panatmospheric-voyage/filament-winder/Electronics/Power Budget.xlsx

Power Rail | FPGA draw | Stepper draw | DAC draw | Heating element draw | Fan draw | DC motor draw | Accelerometer draw | Potentiometer draw | Raspberry Pi draw | Ethernet draw | Power draw | Total draw
1V2 | 0.05 |  |  |  |  |  |  |  |  |  |  | 0.05
1V65 |  |  |  |  |  |  |  |  |  | 0.006 |  | 0.006
3V3 | 0.13 |  | 0.004 |  |  |  | 0.001 | 0.2 |  |  | 0.056 | 0.391
5V |  |  |  |  |  |  |  |  | 2 |  | 0.25806 | 2.25806
12V |  |  |  |  | 0.14 |  |  |  |  |  | 9 | 9.14
STEPPER |  | 3 |  |  |  |  |  |  |  |  |  | 3
HEATER |  |  |  | 6 |  |  |  |  |  |  |  | 6
MOTOR |  |  |  |  |  | 50 |  |  |  |  |  | 50
