panatmospheric-voyage/filament-winder/Laser-Cutting.xlsx

Part | Configuration | Count | Thickness | Fit Against
Axle Support | Default | 2 | 0.5 | Bearing
Basin Plate | Default | 1 | 0.5 | Epoxy Plate
Carver Centering Ring | Forward | 1 | 0.5 | Clamp
Carver Centering Ring | Rear | 1 | 0.5 | Clamp
Centering Ring | 3-8in - 0.5in schedule 40 | 2 | 0.5 | 0.5" PVC
Centering Ring | 5mm - 1in schedule 40 | 4 | 0.5 | 1" PVC
Centering Ring | Inside Spool | 2 | 0.5 | Spool
Centering Ring | Outside Spool | 2 | 0.25 | Spool
Chord Ring | Horizontal | 4 | 0.5 | Chord Ring, Pulley Plate
Chord Ring | Vertical | 2 | 0.5 | Chord Ring, Pulley Plate
Clamp | Default | 4 | 0.5 | Carver Centering Ring
Clamp Plate | Thick | 1 | 0.5
Clamp Plate | Thin | 1 | 0.25
Epoxy Plate | Default | 2 | 0.5 | Basin Plate
Fan Plate | Inside | 1 | 0.5 | Fan
Fan Plate | Outside | 1 | 0.25 | Fan
Filament Guide | Default | 1 | 0.25
Filament Plate | Default | 2 | 0.5 | Bearing
Idler Plate | Inner | 3 | 0.25
Idler Plate | Outer | 1 | 0.5
Pipe Plate | Bottom Mount | 1 | 0.5
Pipe Plate | Side Mount | 1 | 0.5
Pulley Plate | Default | 2 | 0.5 | Chord Ring
Resistance Strip Mold - End Cap | Default | 4 | 0.25 | 2020, Resistance Strip Mold - Side Strip
Resistance Strip Mold - Side Strip | Default | 10 | 0.25 | 2020, Resistance Strip Mold - End Cap
Stepper Plate | Narrow | 3 | 0.25 | Stepper
Stepper Plate | Wide | 2 | 0.25 | Stepper
Wheel Bracket | Default | 4 | 0.5
Wheel Bracket | Potentiometer | 1 | 0.5
Z Pulley | Theta Axis | 1 | 0.5 | Belt
Z Pulley | Z Axis | 1 | 0.5 | Belt
