panatmospheric-voyage/filament-winder/Resistance Strip Mold.SLDASM

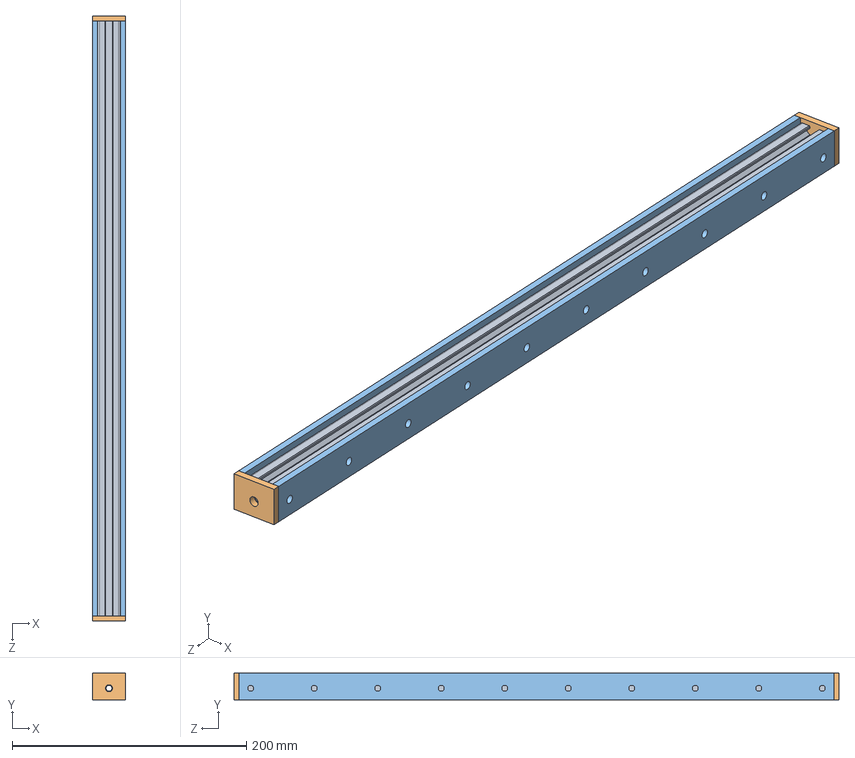
[picture p1: CAD file, 2019-07-26]
Resistance Strip Mold.SLDASM
28.6 x 23.0 x 516.6 mm
Aluminum Extrusion
Resistance Strip Mold - End Cap x 2
Resistance Strip Mold - Side Strip x 2
