panatmospheric-voyage/filament-winder/Gantry Z.SLDASM

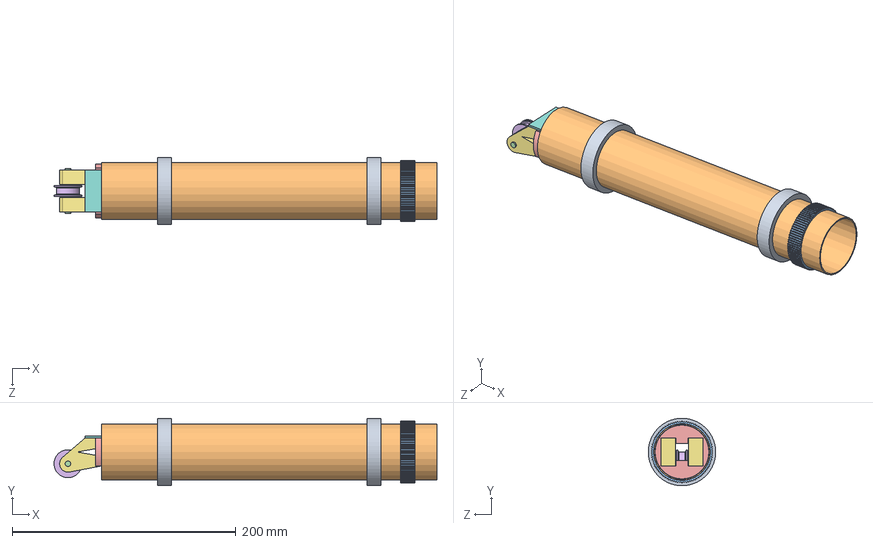
[picture p2: CAD file, 2019-07-26]
Gantry Z.SLDASM
342.5 x 60.3 x 60.3 mm
Bearing x 3
Pipe
Z Pulley
Axle
Chord Ring x 6
Filament Pulley
Pulley Plate x 2
Accelerometer PCB
