panatmospheric-voyage/filament-winder/Roller.SLDASM

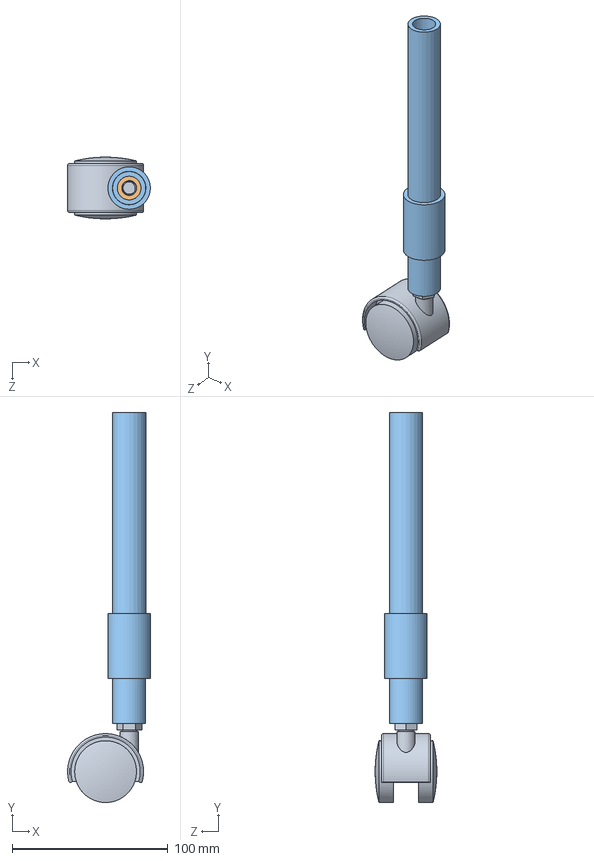
[picture p3: CAD file, 2019-07-26]
Roller.SLDASM
53.2 x 250.6 x 39.7 mm
24215T350_LIGHT DUTY CASTER WITH HOOD
Centering Ring
Pipe x 3
