panatmospheric-voyage/filament-winder/Filament Tool.SLDASM

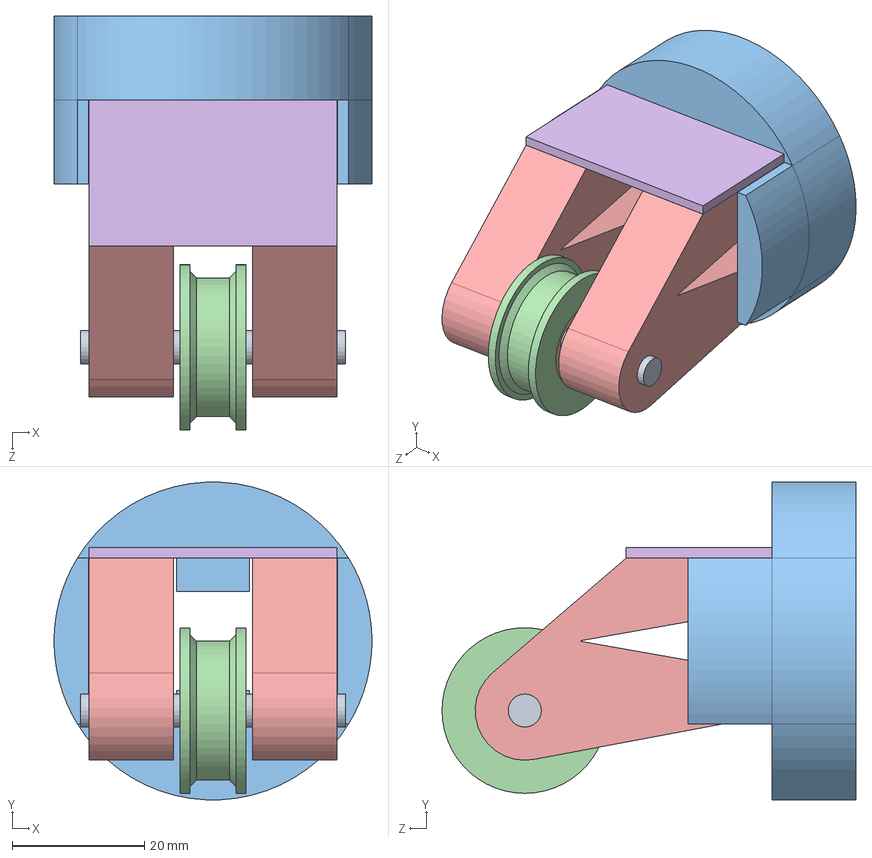
[picture p4: CAD file, 2019-07-26]
Filament Tool.SLDASM
48.0 x 47.9 x 62.5 mm
Axle
Bearing
Chord Ring x 6
Filament Pulley
Pulley Plate x 2
Accelerometer PCB
