panatmospheric-voyage/filament-winder/Rotating Assembly.SLDASM

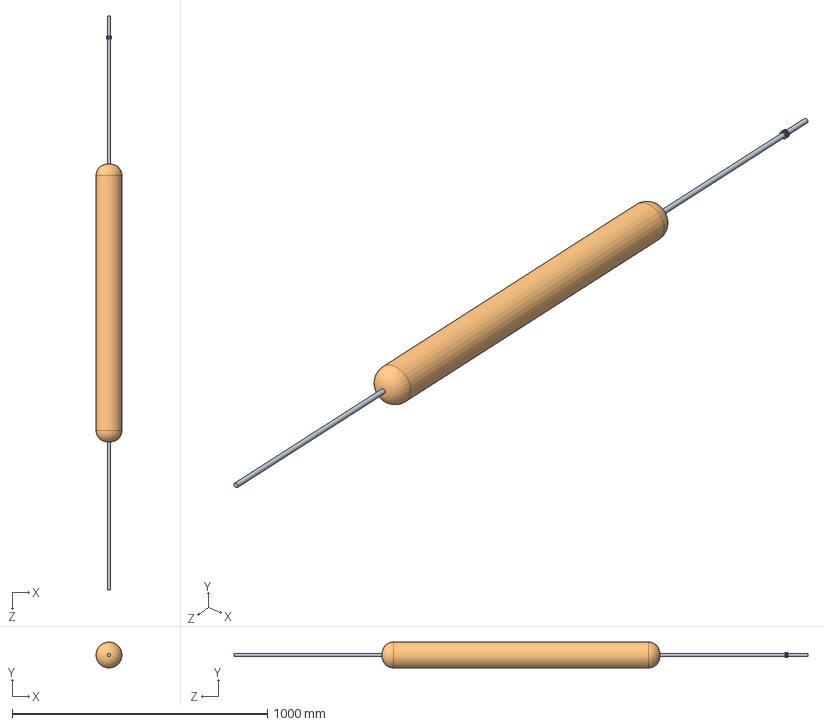
[picture p5: CAD file, 2019-07-26]
Rotating Assembly.SLDASM
101.6 x 101.6 x 2250.0 mm
Axle
Example Mandrel
Z Pulley
