panatmospheric-voyage/filament-winder/MDF 0.5in - Filament Winder.SLDASM

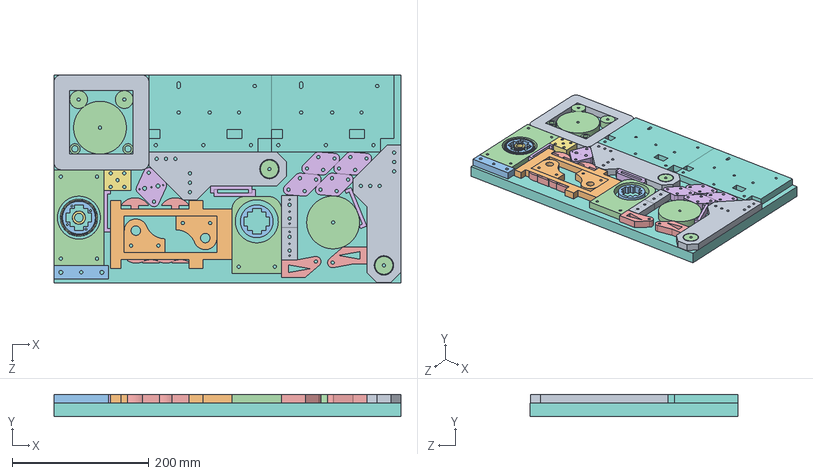
[picture p6: CAD file, 2019-07-26]
MDF 0.5in - Filament Winder.SLDASM
508.0 x 32.7 x 304.8 mm
Axle Support x 2
Basin Plate
Carver Centering Ring x 2
Centering Ring x 8
Chord Ring x 6
Clamp x 4
Clamp Plate
Epoxy Plate x 2
Fan Plate
Filament Plate x 2
Idler Plate
Pipe Plate x 2
Pulley Plate x 2
Wheel Bracket x 5
Z Pulley x 2
Laser Sheet
Potentiometer Plate x 2
