panatmospheric-voyage/filament-winder/MDF 0.25in - Filament Winder.SLDASM

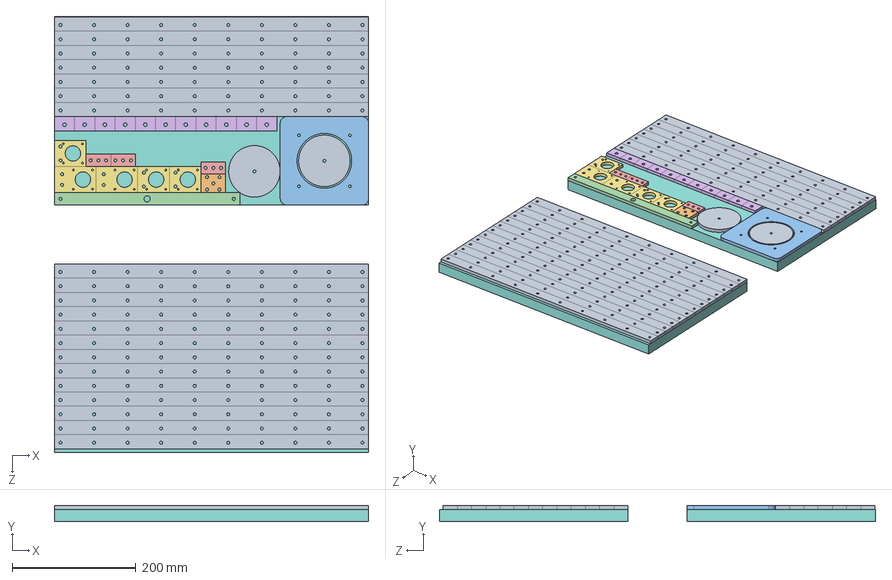
[picture p7: CAD file, 2019-07-26]
MDF 0.25in - Filament Winder.SLDASM
508.0 x 26.4 x 704.8 mm
Centering Ring x 2
Clamp Plate
Fan Plate
Filament Guide
Idler Plate x 3
Resistance Strip Mold - End Cap x 11
Stepper Plate x 5
Laser Sheet x 2
Resistance Strip Mold - Side Strip x 20
