panatmospheric-voyage/filament-winder/Gantry X.SLDASM

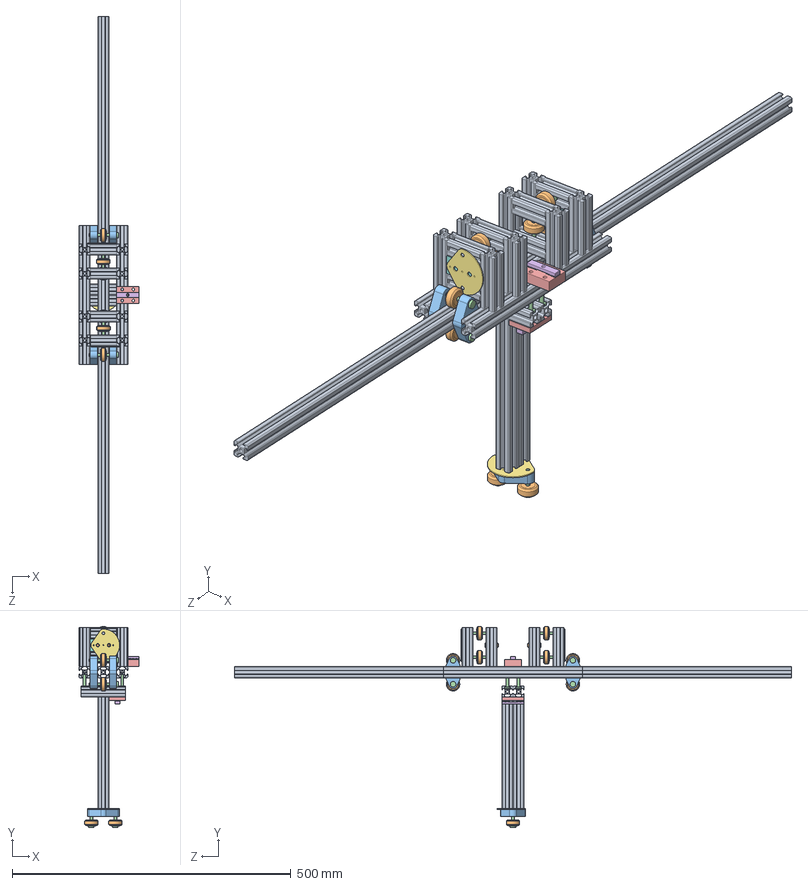
[picture p8: CAD file, 2019-07-26]
Gantry X.SLDASM
107.4 x 360.5 x 1000.0 mm
Wheel x 12
Wheel Bracket x 5
Aluminum Extrusion x 22
Bolt x 16
Clamp Plate x 2
Gear Clamp x 2
Potentiometer PCB x 3
Potentiometer Plate x 2
