panatmospheric-voyage/filament-winder/Base.SLDASM

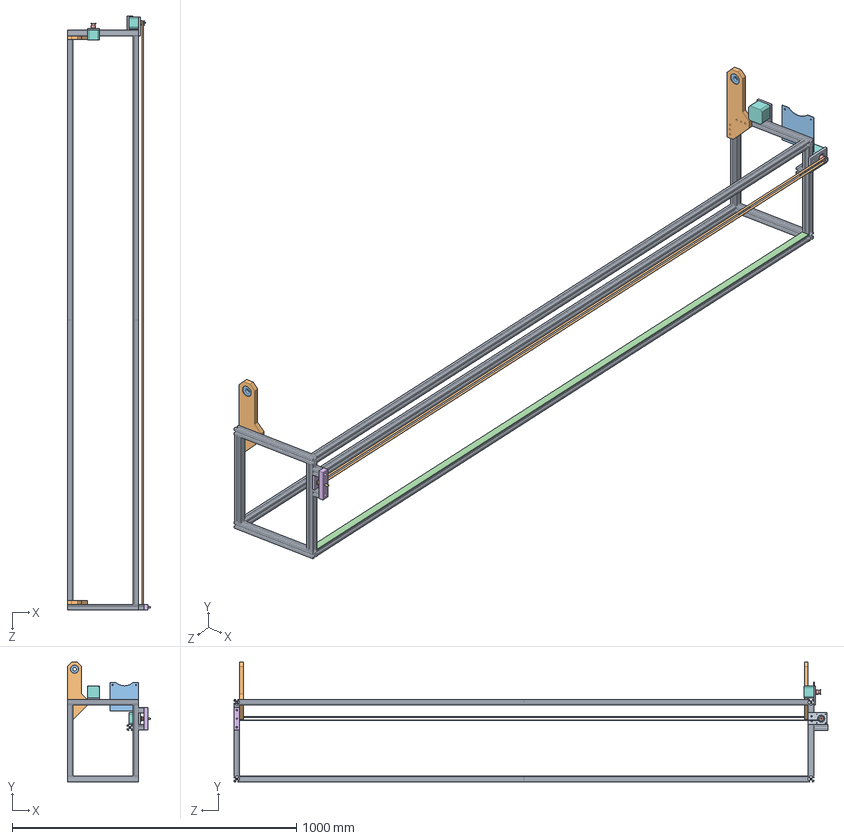
[picture p9: CAD file, 2019-07-26]
Base.SLDASM
292.0 x 421.4 x 2090.0 mm
Aluminum Extrusion x 17
Axle Support x 2
Bearing x 2
Resistance Strip
Pulley x 3
Idler Plate x 2
Axle
Stepper Motor x 2
Stepper Plate x 2
Belt
Control PCB
