panatmospheric-voyage/filament-winder/Carving Tool.SLDASM

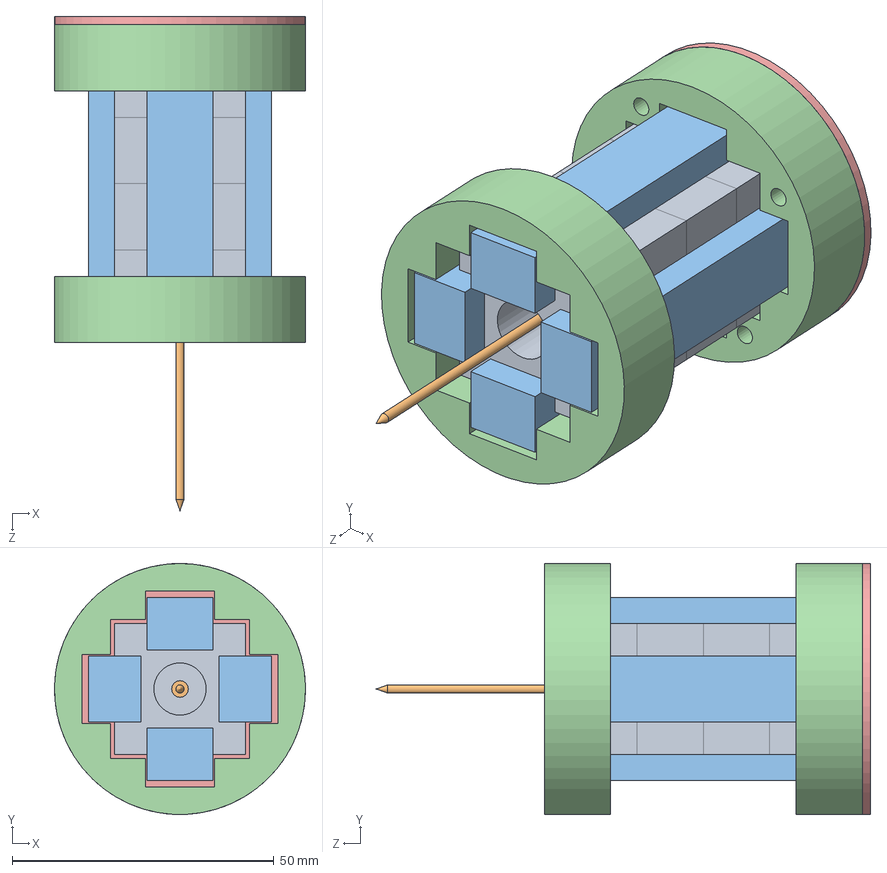
[picture p10: CAD file, 2019-07-26]
Carving Tool.SLDASM
48.0 x 48.0 x 94.5 mm
Insulation Square x 4
Nail
Clamp x 4
Carver Centering Ring x 2
Carver PCB
