panatmospheric-voyage/filament-winder/MDF 0.5in - Filament Winder - 2.SLDASM

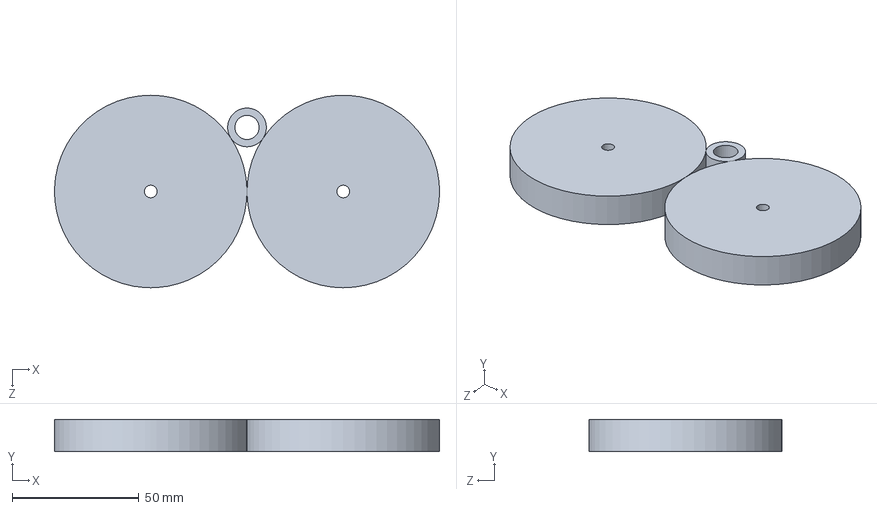
[picture p11: CAD file, 2019-07-26]
MDF 0.5in - Filament Winder - 2.SLDASM
152.0 x 12.7 x 76.0 mm
Centering Ring x 3
