panatmospheric-voyage/filament-winder/Gantry Y.SLDASM

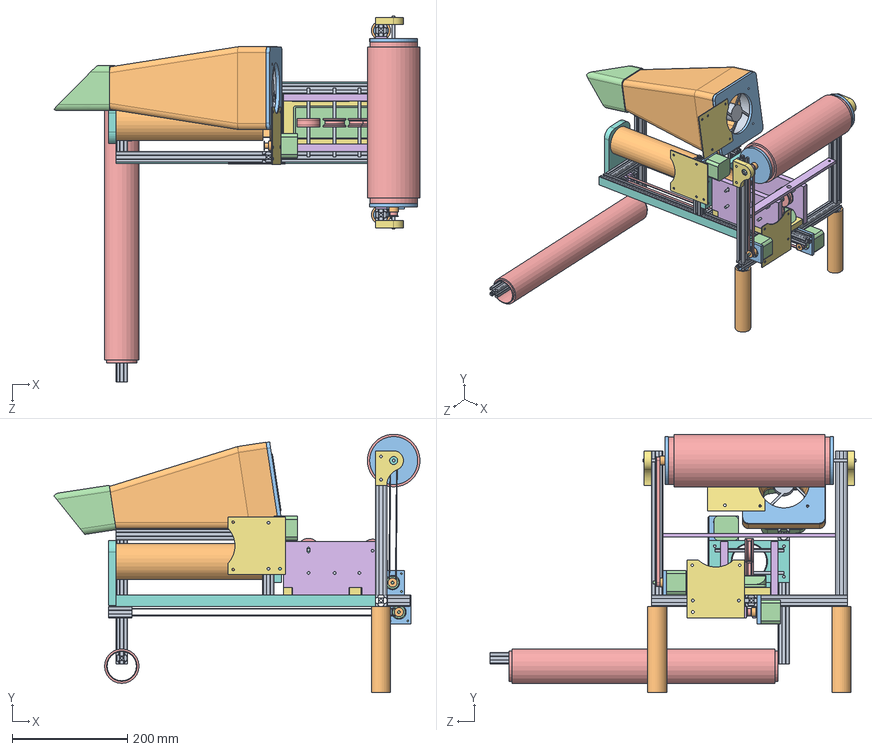
[picture p12: CAD file, 2019-07-26]
Gantry Y.SLDASM
635.4 x 448.5 x 635.0 mm
Aluminum Extrusion x 16
Pipe x 3
Centering Ring x 8
Basin
Filament Spool x 2
Filament Guide
Filament Plate x 2
Bearing x 7
Axle x 6
Pulley x 5
Stepper Plate x 3
Stepper Motor x 3
Filament Pulley x 5
Epoxy Plate x 2
Basin Plate
Pipe Plate x 2
Fan
Heating Chamber
Fan Plate x 2
Heat Attachment
Belt x 2
Idler Plate x 2
Control PCB x 3
Resistance Strip x 2
