panatmospheric-voyage/filament-winder/Filament Winder.SLDASM

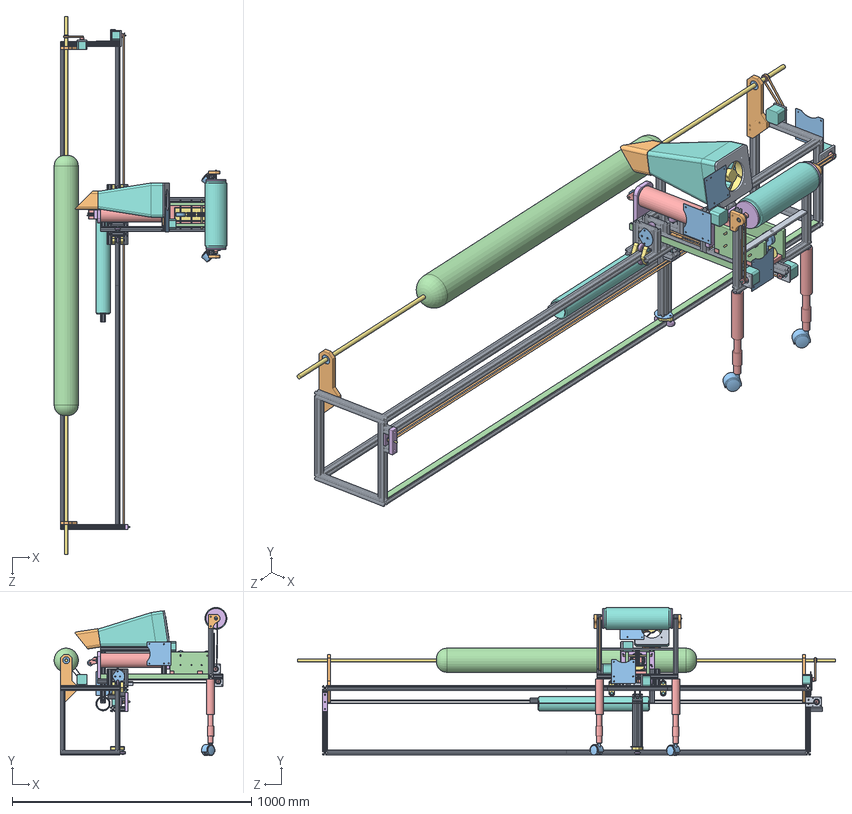
[picture p13: CAD file, 2019-07-26]
Filament Winder.SLDASM
722.4 x 619.1 x 2250.0 mm
Aluminum Extrusion x 55
Axle Support x 2
Bearing x 12
Resistance Strip x 3
Pulley x 8
Idler Plate x 4
Axle x 9
Stepper Motor x 5
Stepper Plate x 5
Belt x 5
Control PCB x 4
Example Mandrel
Z Pulley x 2
Wheel x 12
Wheel Bracket x 5
Bolt x 16
Clamp Plate x 2
Gear Clamp x 2
Potentiometer PCB x 3
Potentiometer Plate x 2
Pipe x 10
Centering Ring x 10
Basin
Filament Spool x 2
Filament Guide
Filament Plate x 2
Filament Pulley x 6
Epoxy Plate x 2
Basin Plate
Pipe Plate x 2
Fan
Heating Chamber
Fan Plate x 2
Heat Attachment
24215T350_LIGHT DUTY CASTER WITH HOOD x 2
Chord Ring x 6
Pulley Plate x 2
Accelerometer PCB
