panatmospheric-voyage/filament-winder/Filament Pulley.SLDPRT

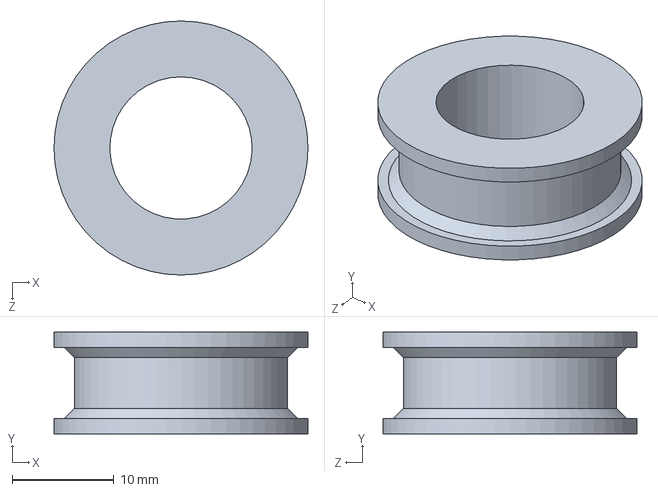
[picture p14: CAD file, 2020-02-10]
Filament Pulley.SLDPRT
25.0 x 10.0 x 25.0 mm
