panatmospheric-voyage/filament-winder/Filament Pulley Injection Mold.SLDPRT

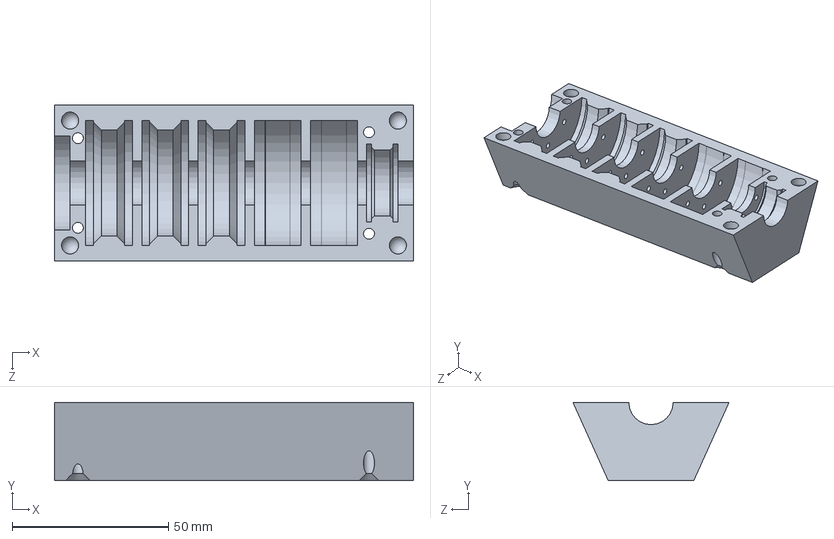
[picture p15: CAD file, 2020-02-10]
Filament Pulley Injection Mold.SLDPRT
115.0 x 25.0 x 50.0 mm
