panatmospheric-voyage/filament-winder/Pulley Plate.SLDPRT

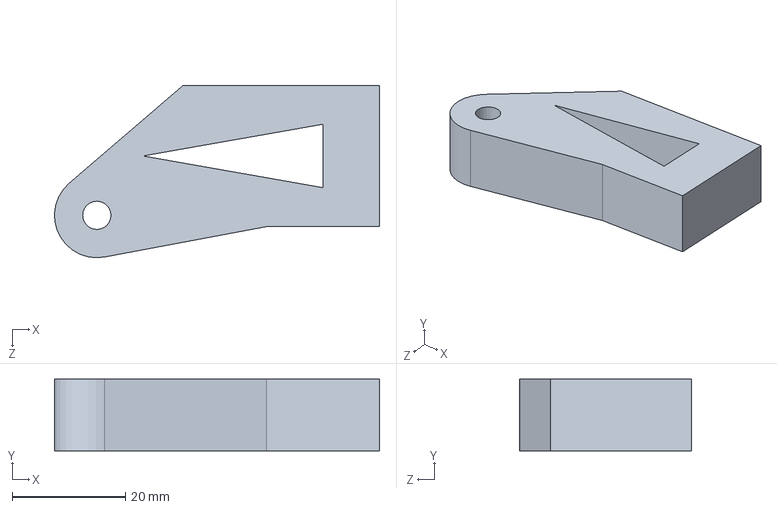
[picture p16: CAD file, 2019-07-26]
Pulley Plate.SLDPRT
57.5 x 12.7 x 30.5 mm
