panatmospheric-voyage/filament-winder/Resistance Strip Mold - Side Strip.SLDPRT

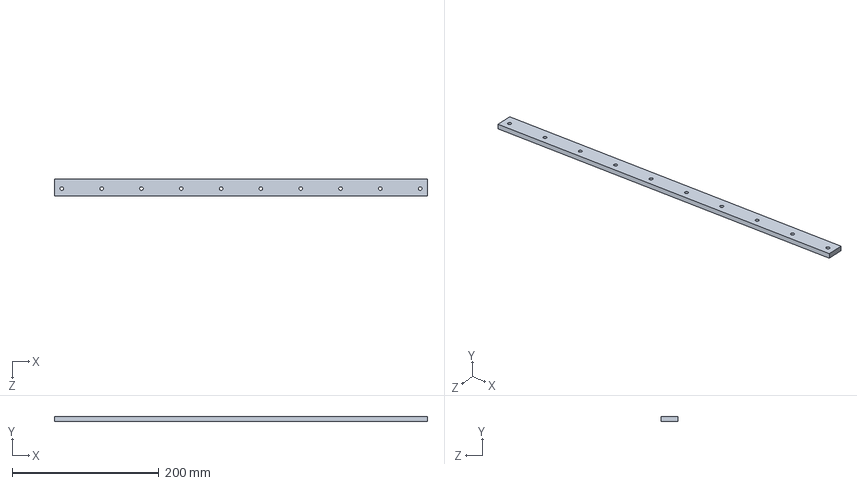
[picture p17: CAD file, 2019-07-26]
Resistance Strip Mold - Side Strip.SLDPRT
508.0 x 6.35 x 23.0 mm
