panatmospheric-voyage/filament-winder/Pulley.SLDPRT

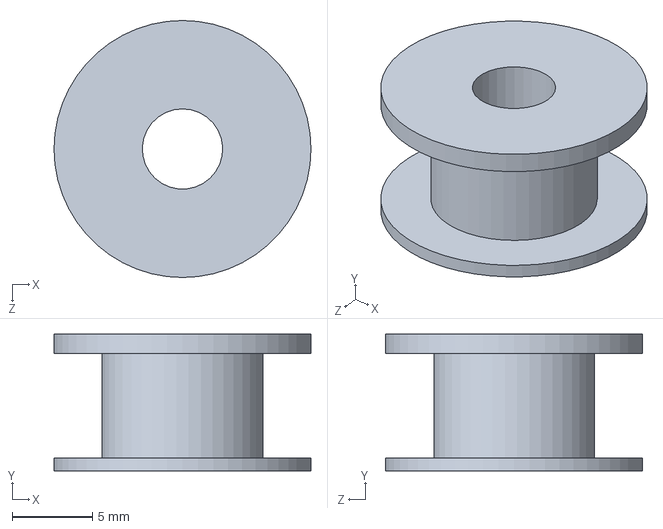
[picture p18: CAD file, 2019-07-26]
Pulley.SLDPRT
16.0 x 8.50 x 16.0 mm
