panatmospheric-voyage/filament-winder/Control PCB.SLDPRT

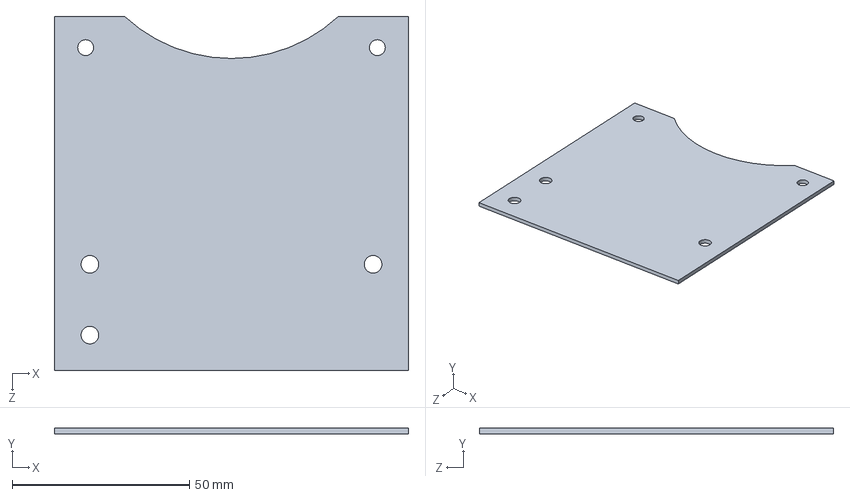
[picture p19: CAD file, 2019-07-26]
Control PCB.SLDPRT
100.0 x 1.60 x 100.0 mm
