panatmospheric-voyage/filament-winder/Bearing.SLDPRT

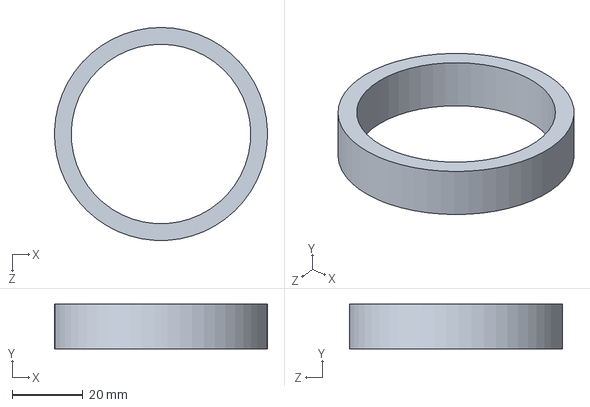
[picture p20: CAD file, 2019-07-26]
Bearing.SLDPRT
60.3 x 12.7 x 60.3 mm
