panatmospheric-voyage/filament-winder/Basin Plate.SLDPRT

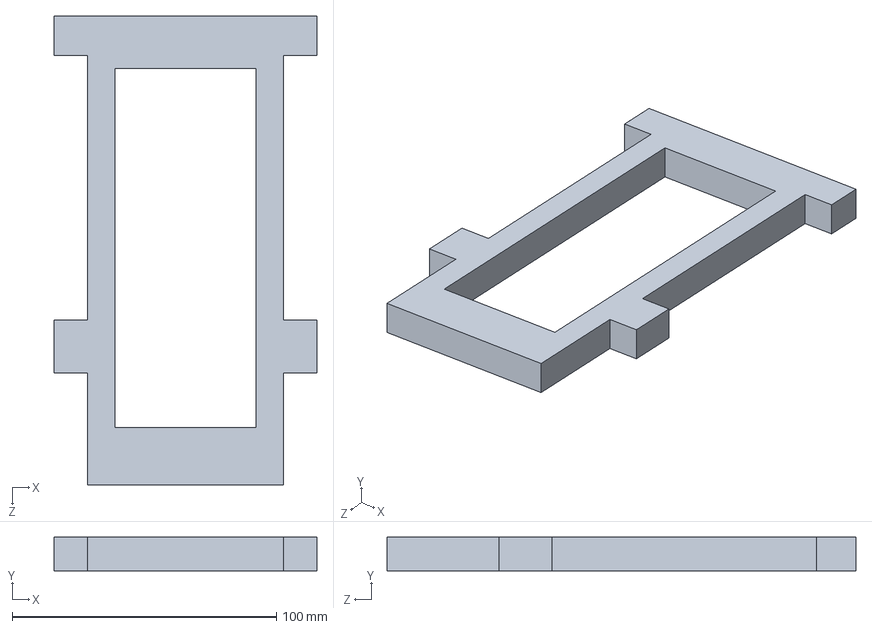
[picture p21: CAD file, 2019-07-26]
Basin Plate.SLDPRT
99.4 x 12.7 x 177.4 mm
