panatmospheric-voyage/filament-winder/Aluminum Extrusion.SLDPRT

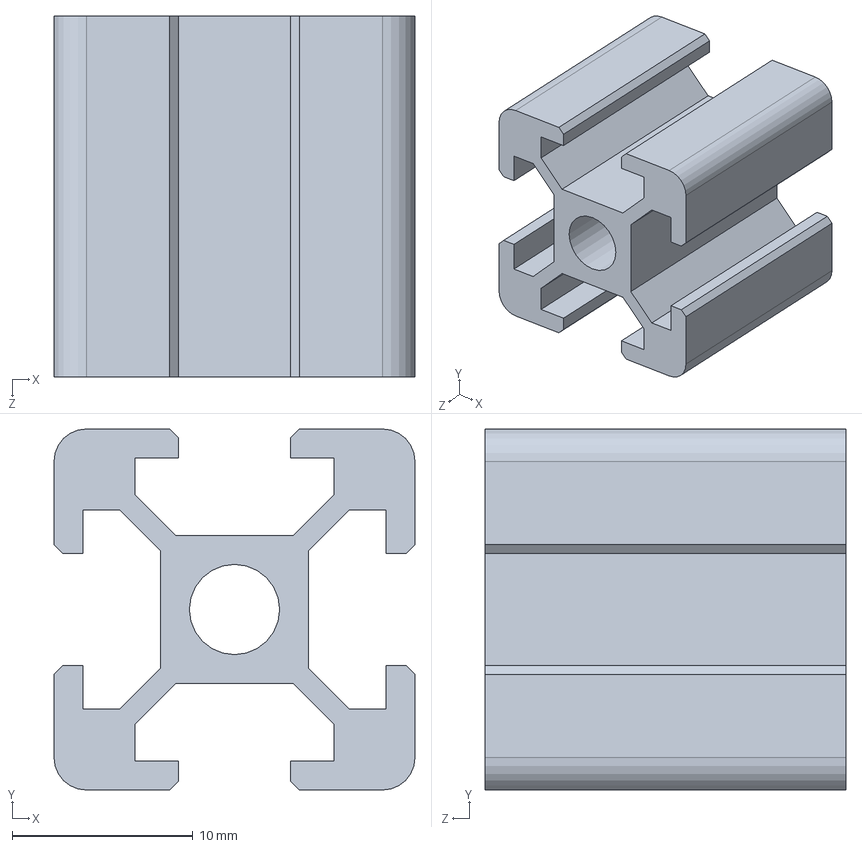
[picture p22: CAD file, 2019-07-26]
Aluminum Extrusion.SLDPRT
20.0 x 20.0 x 20.0 mm
