panatmospheric-voyage/filament-winder/Filament Pulley Injection Mold - Female.STL

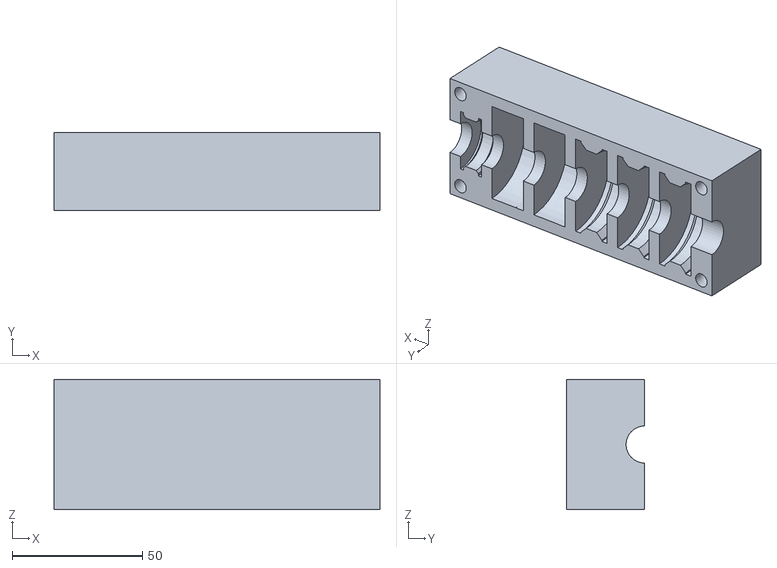
[picture p23: CAD file, 2019-07-26]
Filament Pulley Injection Mold - Female.STL
125.0 x 30.0 x 50.0
