panatmospheric-voyage/filament-winder/Epoxy Plate.SLDPRT

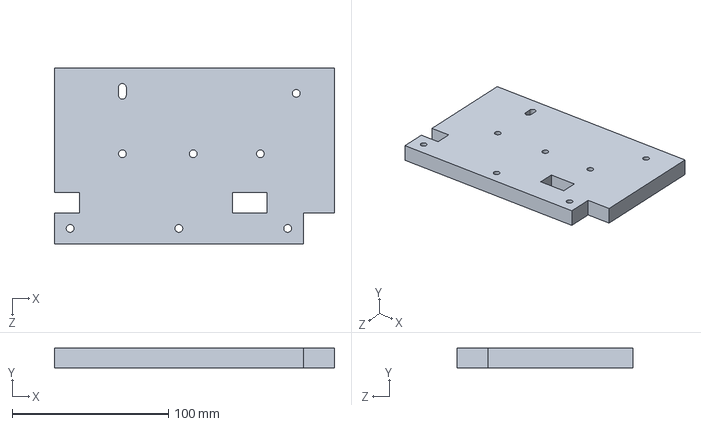
[picture p24: CAD file, 2019-07-26]
Epoxy Plate.SLDPRT
179.4 x 12.7 x 112.8 mm
