panatmospheric-voyage/filament-winder/Fan Plate.SLDPRT

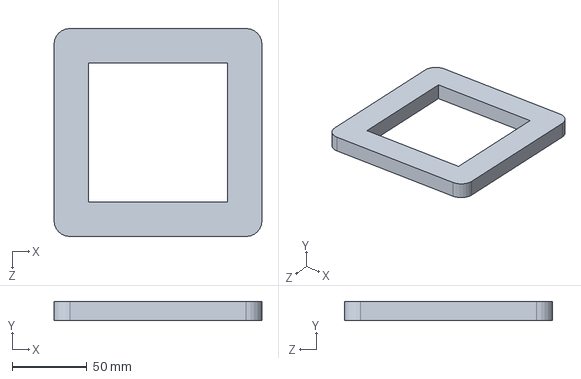
[picture p25: CAD file, 2019-07-26]
Fan Plate.SLDPRT
139.0 x 12.7 x 139.0 mm
