panatmospheric-voyage/filament-winder/MDF 0.5in - Filament Winder - 1.DXF

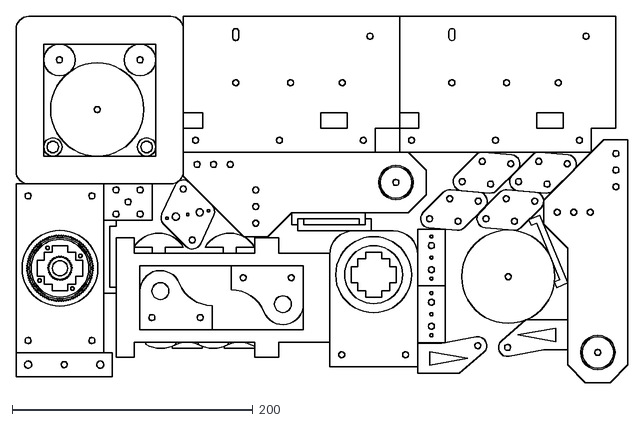
[picture p26: CAD file, 2019-07-26]
MDF 0.5in - Filament Winder - 1.DXF
508.0 x 303.9
