panatmospheric-voyage/filament-winder/PVC Quarter Jig.SLDPRT

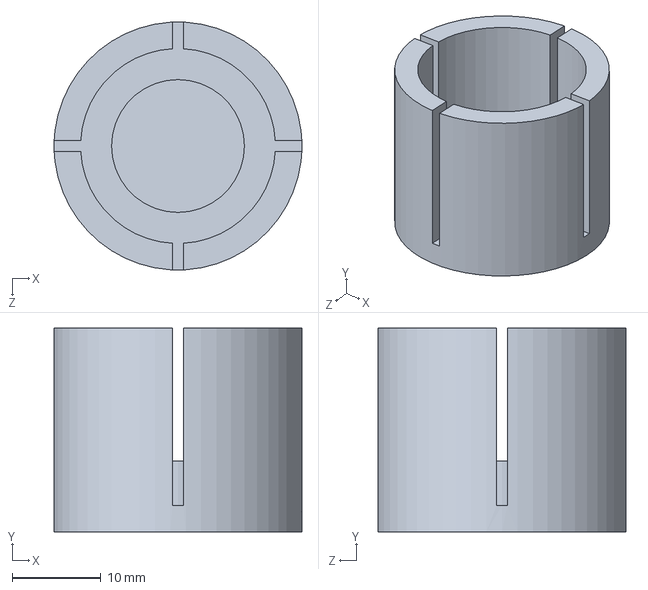
[picture p27: CAD file, 2019-07-26]
PVC Quarter Jig.SLDPRT
28.0 x 23.0 x 28.0 mm
