panatmospheric-voyage/filament-winder/Nail.SLDPRT

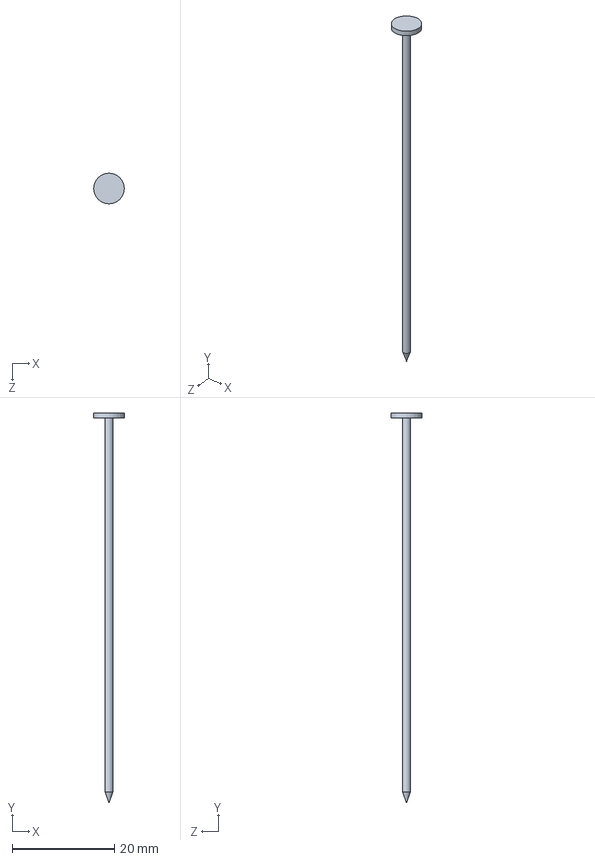
[picture p28: CAD file, 2019-07-26]
Nail.SLDPRT
6.00 x 76.2 x 6.00 mm
