panatmospheric-voyage/filament-winder/Z Pulley.SLDPRT

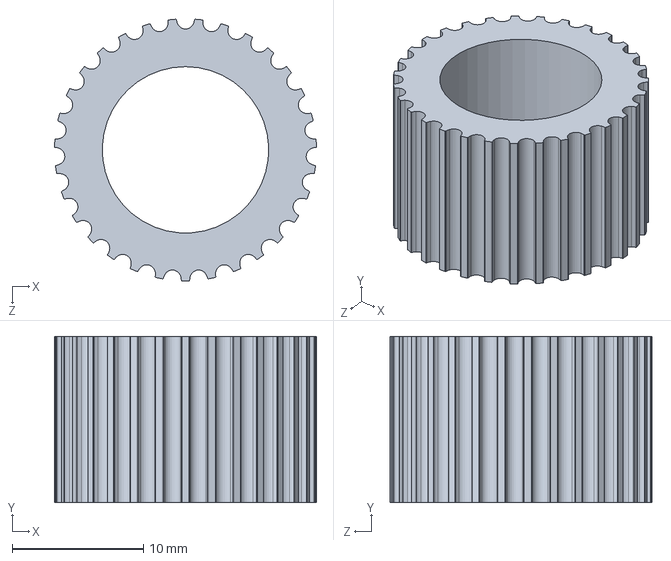
[picture p29: CAD file, 2019-07-26]
Z Pulley.SLDPRT
20.0 x 12.7 x 20.0 mm
