panatmospheric-voyage/filament-winder/Axle Support.SLDPRT

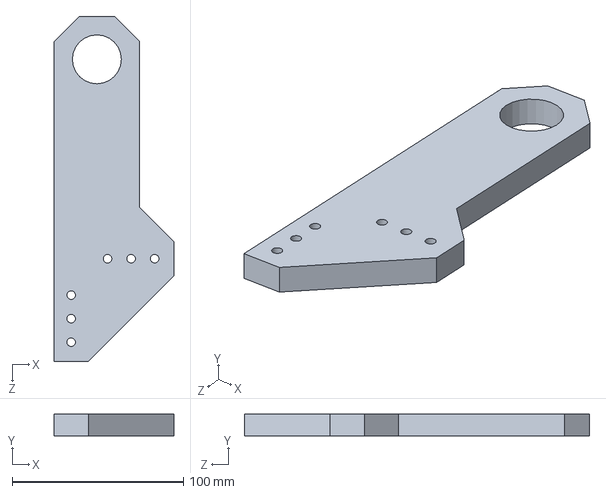
[picture p30: CAD file, 2019-07-26]
Axle Support.SLDPRT
70.0 x 12.7 x 201.4 mm
