panatmospheric-voyage/filament-winder/Resistance Strip.SLDPRT

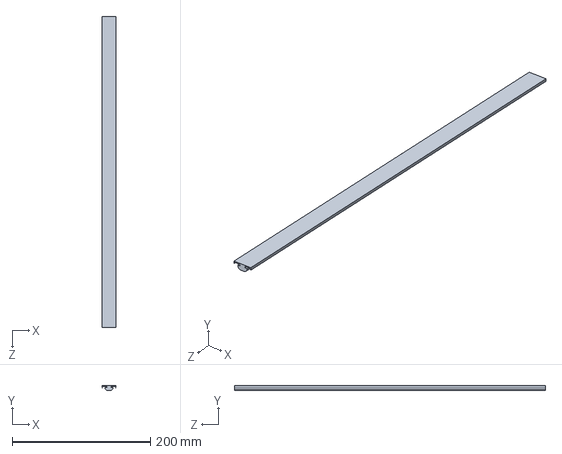
[picture p31: CAD file, 2019-07-26]
Resistance Strip.SLDPRT
20.0 x 6.90 x 450.0 mm
