panatmospheric-voyage/filament-winder/Stepper Motor.SLDPRT

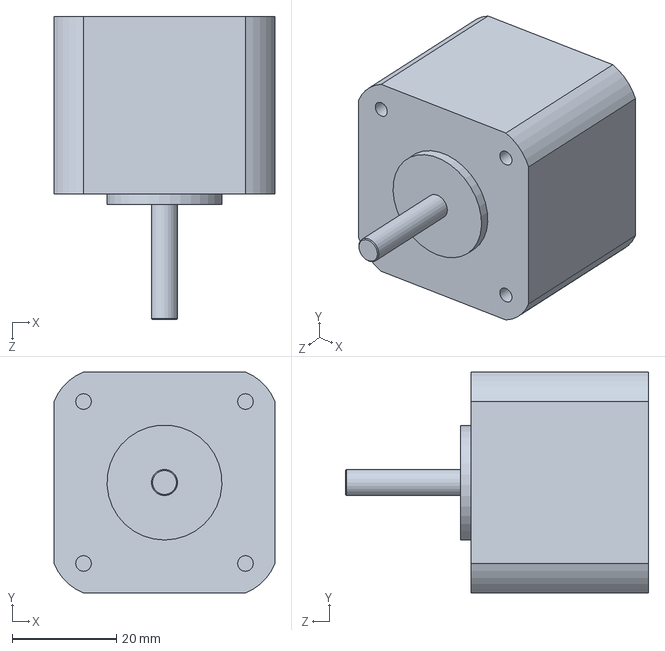
[picture p32: CAD file, 2019-07-26]
Stepper Motor.SLDPRT
42.3 x 42.3 x 58.0 mm
