panatmospheric-voyage/filament-winder/Accelerometer PCB.SLDPRT

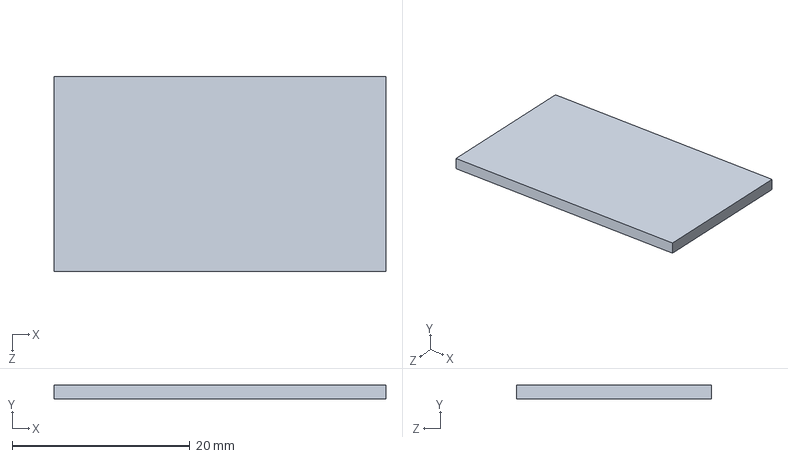
[picture p33: CAD file, 2019-07-26]
Accelerometer PCB.SLDPRT
37.4 x 1.60 x 22.0 mm
