panatmospheric-voyage/filament-winder/MDF 0.25in - Filament Winder - 2.DXF

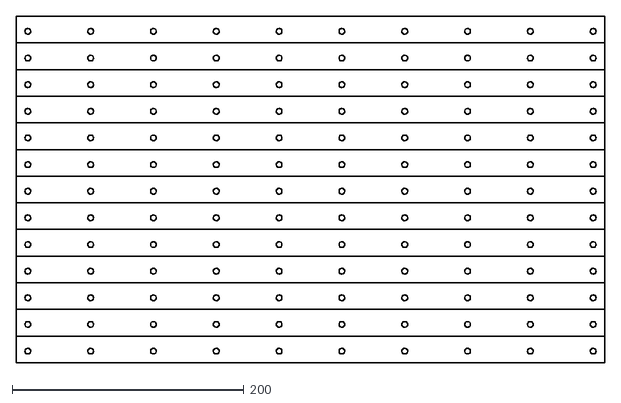
[picture p34: CAD file, 2019-07-26]
MDF 0.25in - Filament Winder - 2.DXF
508.0 x 299.0
