panatmospheric-voyage/filament-winder/Belt Tool.SLDPRT

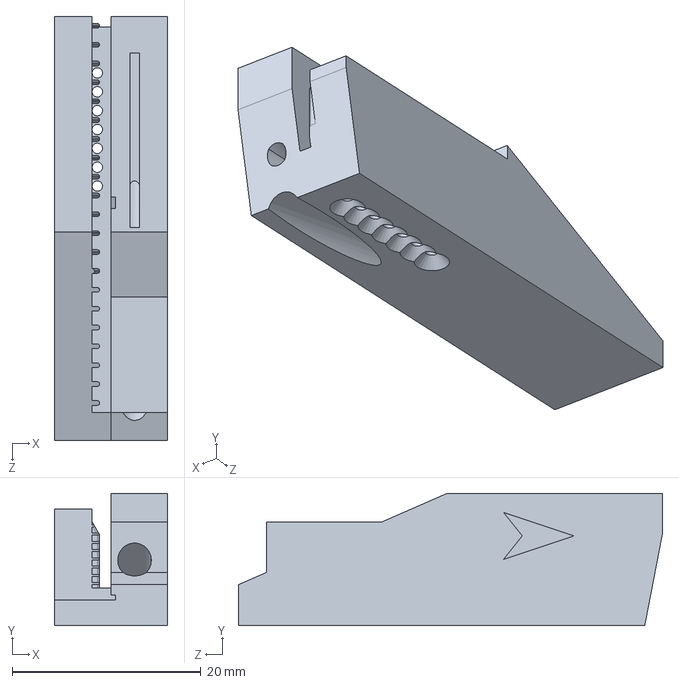
[picture p35: CAD file, 2019-07-26]
Belt Tool.SLDPRT
12.0 x 14.0 x 45.0 mm
