panatmospheric-voyage/filament-winder/Chord Ring.SLDPRT

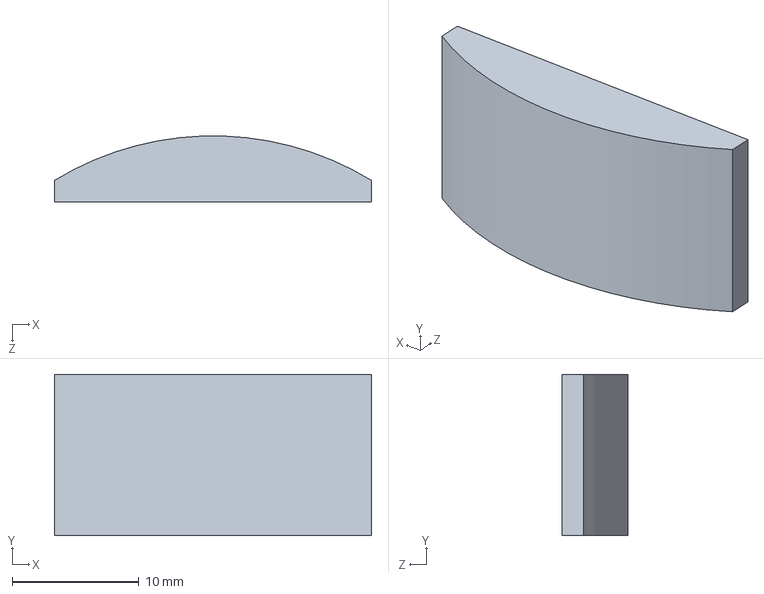
[picture p36: CAD file, 2019-07-26]
Chord Ring.SLDPRT
25.0 x 12.7 x 5.20 mm
