panatmospheric-voyage/filament-winder/Belt.SLDPRT

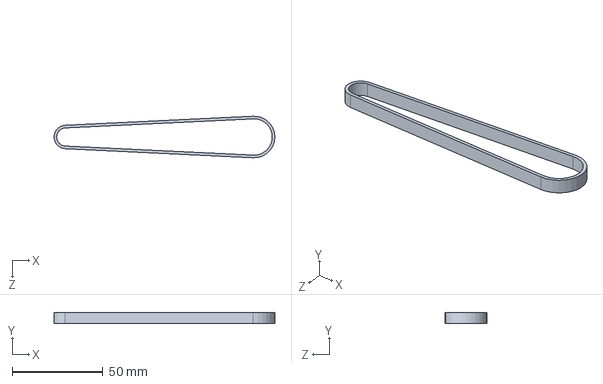
[picture p37: CAD file, 2019-07-26]
Belt.SLDPRT
122.0 x 6.00 x 23.0 mm
