panatmospheric-voyage/filament-winder/Centering Ring.SLDPRT

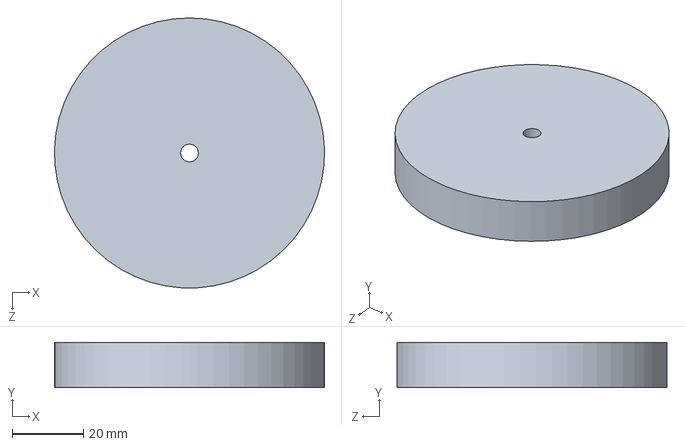
[picture p38: CAD file, 2019-07-26]
Centering Ring.SLDPRT
76.0 x 12.7 x 76.0 mm
