panatmospheric-voyage/filament-winder/Wheel Bracket.SLDPRT

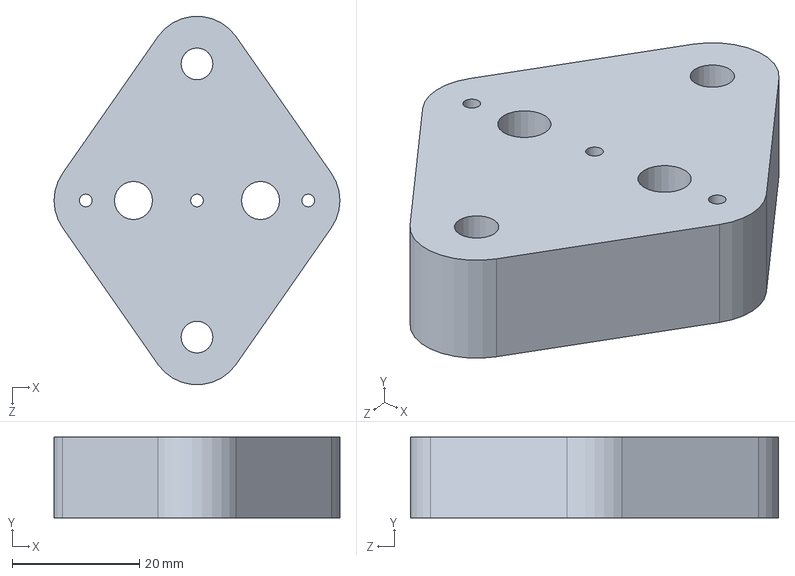
[picture p39: CAD file, 2019-07-26]
Wheel Bracket.SLDPRT
45.0 x 12.7 x 57.9 mm
