panatmospheric-voyage/filament-winder/Wheel.SLDPRT

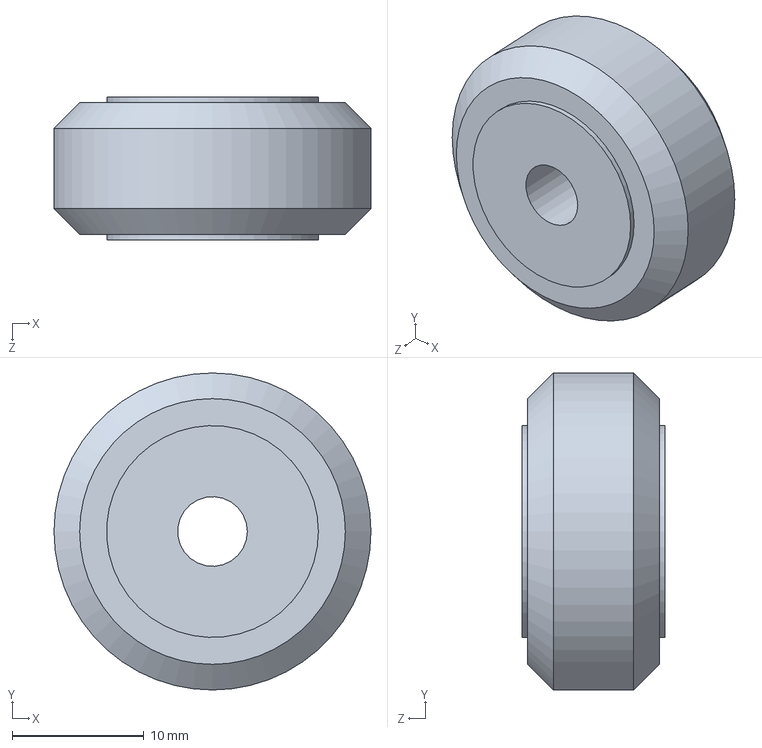
[picture p40: CAD file, 2019-07-26]
Wheel.SLDPRT
24.1 x 24.1 x 10.9 mm
