panatmospheric-voyage/filament-winder/Pipe.SLDPRT

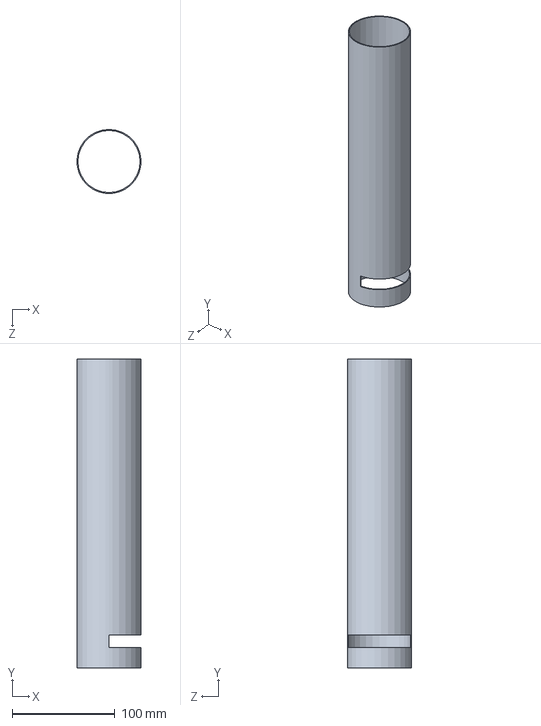
[picture p41: CAD file, 2019-07-26]
Pipe.SLDPRT
62.2 x 300.0 x 62.3 mm
