panatmospheric-voyage/filament-winder/Filament Spool.SLDPRT

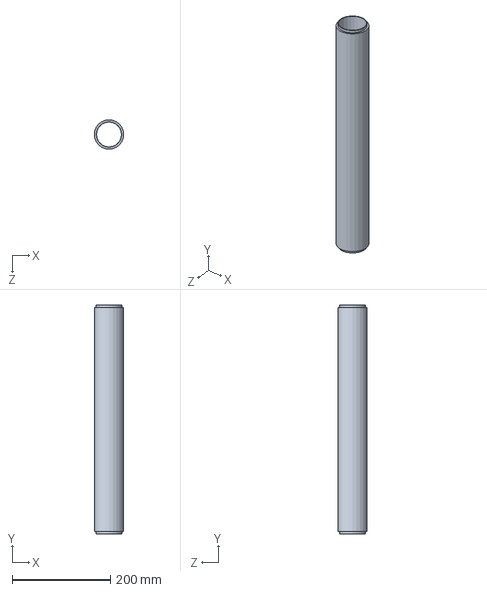
[picture p42: CAD file, 2019-07-26]
Filament Spool.SLDPRT
60.0 x 467.2 x 60.0 mm
