panatmospheric-voyage/filament-winder/Basin.SLDPRT

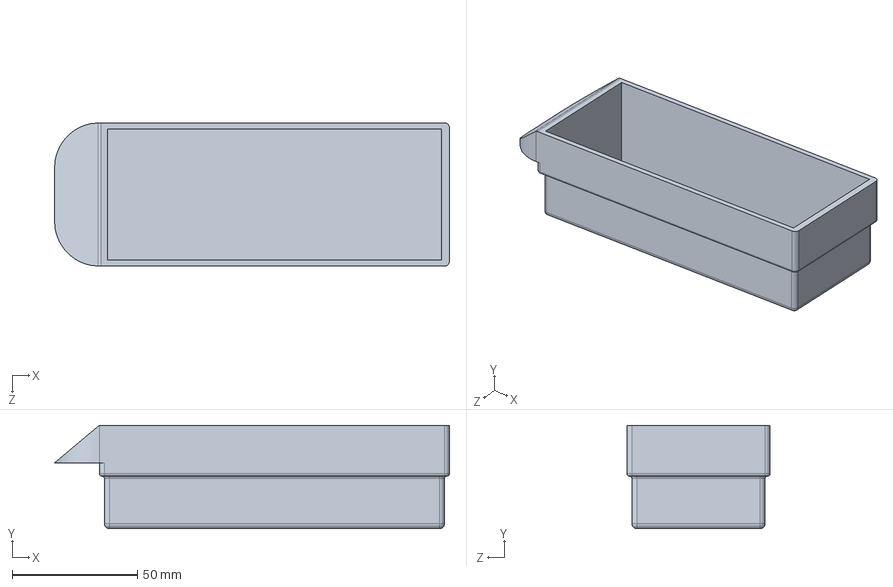
[picture p43: CAD file, 2019-07-26]
Basin.SLDPRT
157.6 x 41.3 x 57.1 mm
