panatmospheric-voyage/filament-winder/Gear Clamp.SLDPRT

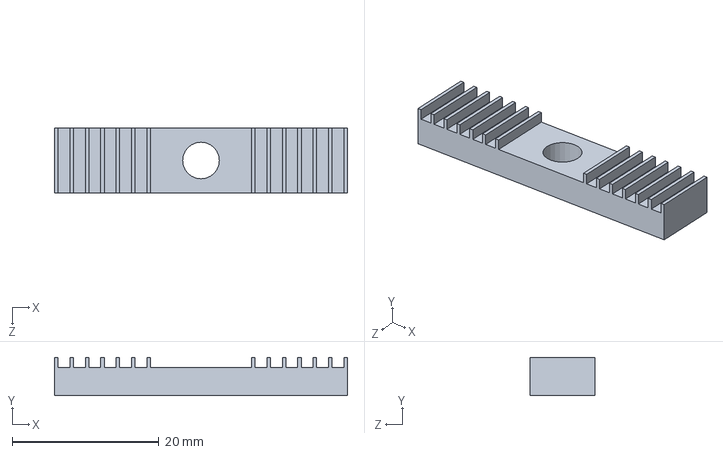
[picture p44: CAD file, 2019-07-26]
Gear Clamp.SLDPRT
40.0 x 5.20 x 8.90 mm
