panatmospheric-voyage/filament-winder/Stepper Plate.SLDPRT

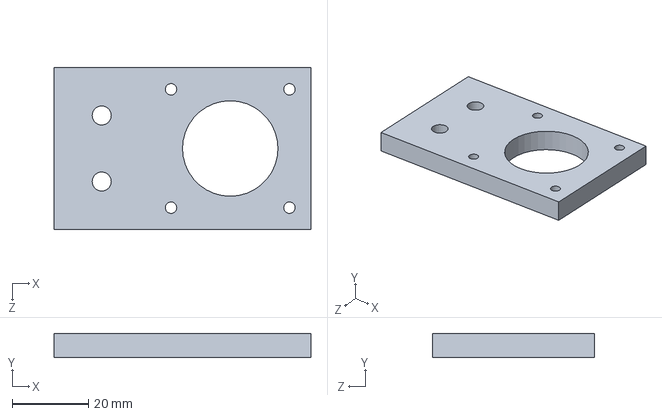
[picture p45: CAD file, 2019-07-26]
Stepper Plate.SLDPRT
67.3 x 6.35 x 42.3 mm
