panatmospheric-voyage/filament-winder/Resistance Strip Mold - End Cap.SLDPRT

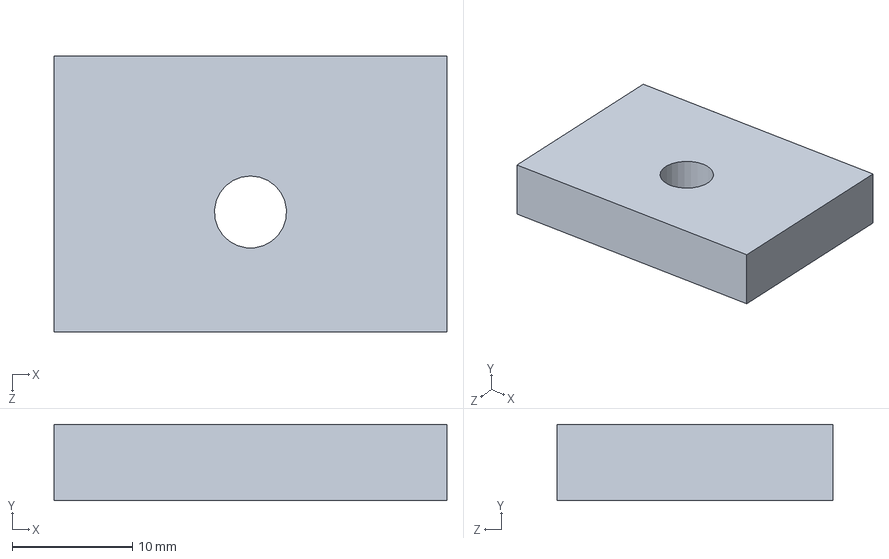
[picture p46: CAD file, 2019-07-26]
Resistance Strip Mold - End Cap.SLDPRT
32.7 x 6.35 x 23.0 mm
