panatmospheric-voyage/filament-winder/Heating Chamber.SLDPRT

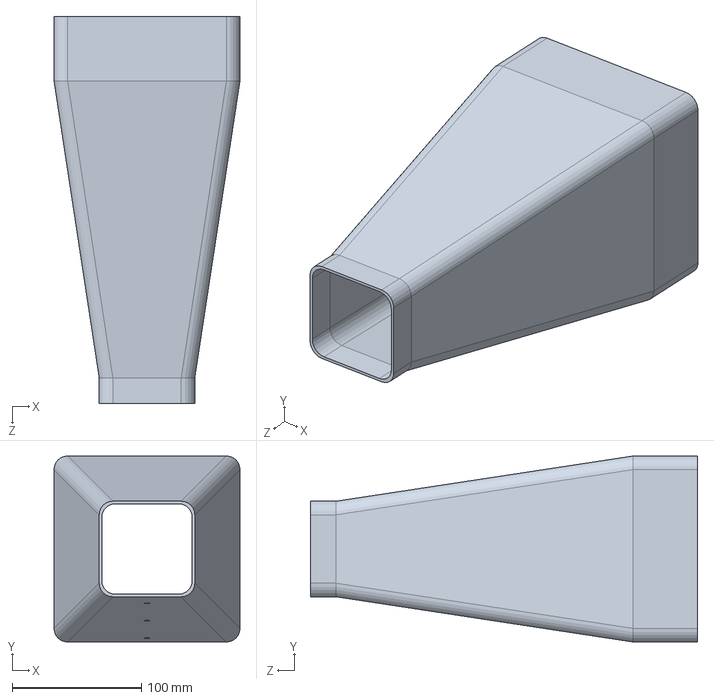
[picture p47: CAD file, 2019-07-26]
Heating Chamber.SLDPRT
144.0 x 144.0 x 300.0 mm
