panatmospheric-voyage/filament-winder/Carver Centering Ring.SLDPRT

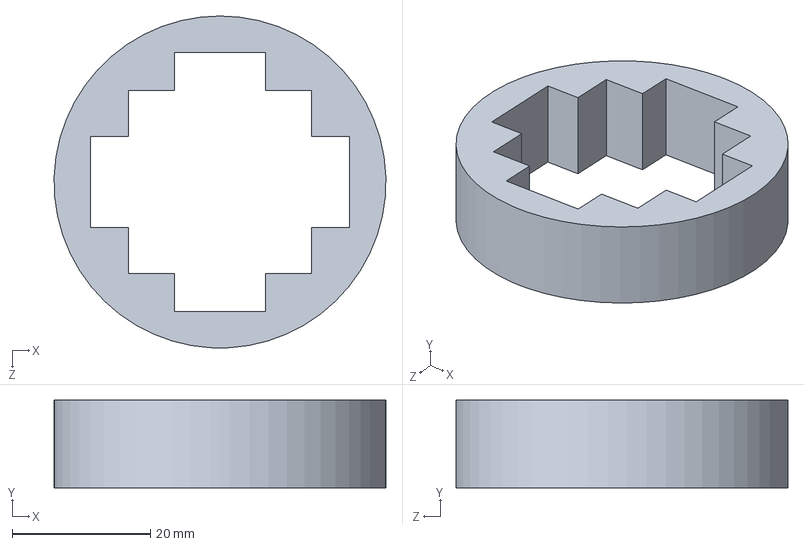
[picture p48: CAD file, 2019-07-26]
Carver Centering Ring.SLDPRT
48.0 x 12.7 x 48.0 mm
