panatmospheric-voyage/filament-winder/Idler Plate.SLDPRT

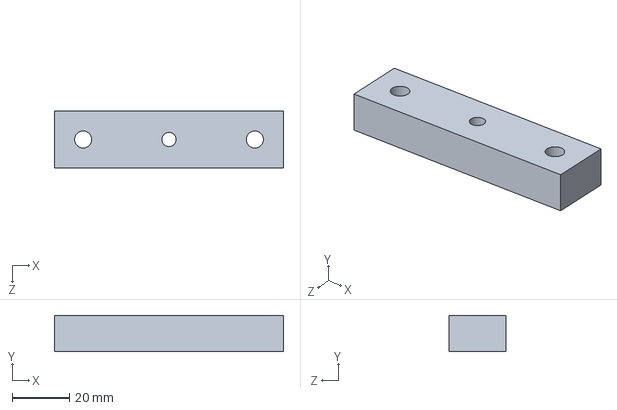
[picture p49: CAD file, 2019-07-26]
Idler Plate.SLDPRT
80.0 x 12.7 x 20.0 mm
