panatmospheric-voyage/filament-winder/Potentiometer Plate.SLDPRT

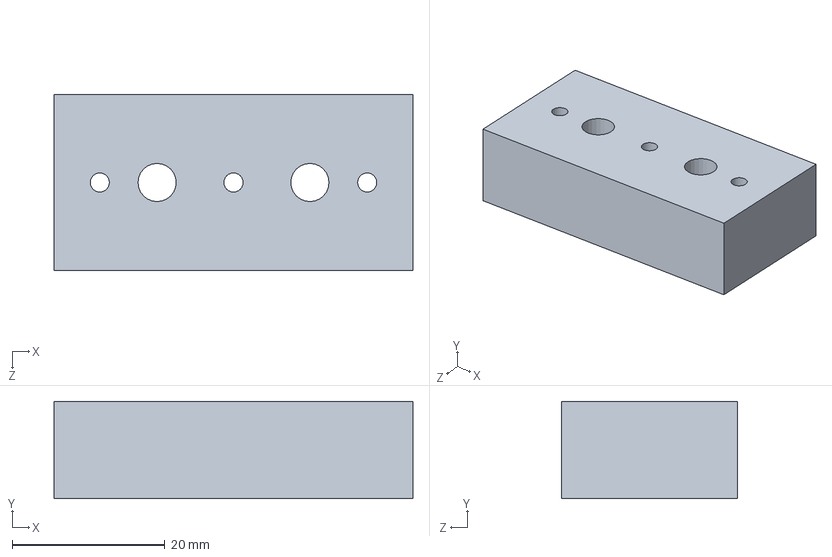
[picture p50: CAD file, 2019-07-26]
Potentiometer Plate.SLDPRT
47.0 x 12.7 x 23.0 mm
