panatmospheric-voyage/filament-winder/Insulation Square.SLDPRT

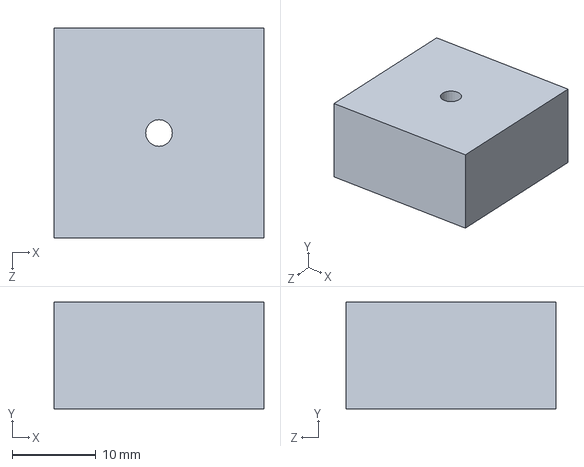
[picture p51: CAD file, 2019-07-26]
Insulation Square.SLDPRT
25.0 x 12.7 x 25.0 mm
