panatmospheric-voyage/filament-winder/Clamp Plate.SLDPRT

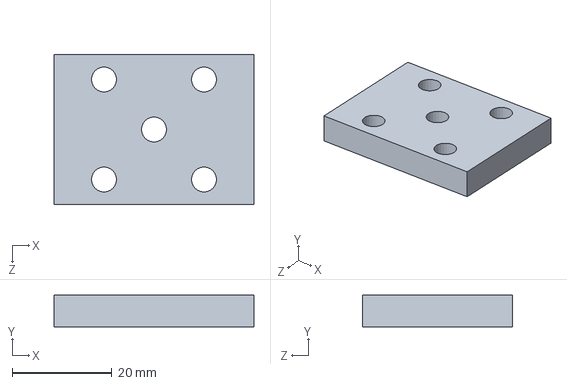
[picture p52: CAD file, 2019-07-26]
Clamp Plate.SLDPRT
40.0 x 6.35 x 30.0 mm
