panatmospheric-voyage/filament-winder/Carver PCB.SLDPRT

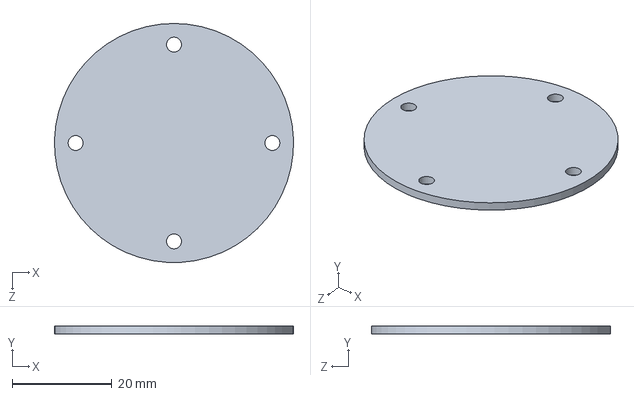
[picture p53: CAD file, 2019-07-26]
Carver PCB.SLDPRT
48.0 x 1.60 x 48.0 mm
