panatmospheric-voyage/filament-winder/Filament Guide.SLDPRT

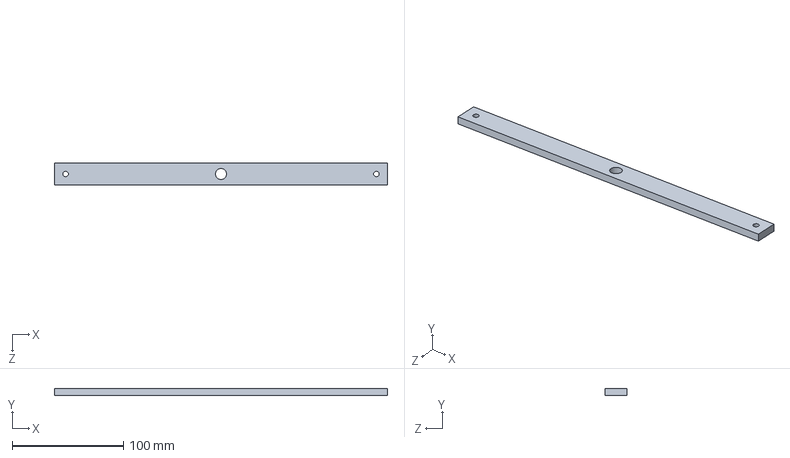
[picture p54: CAD file, 2019-07-26]
Filament Guide.SLDPRT
300.0 x 6.35 x 20.0 mm
