panatmospheric-voyage/filament-winder/Example Mandrel.SLDPRT

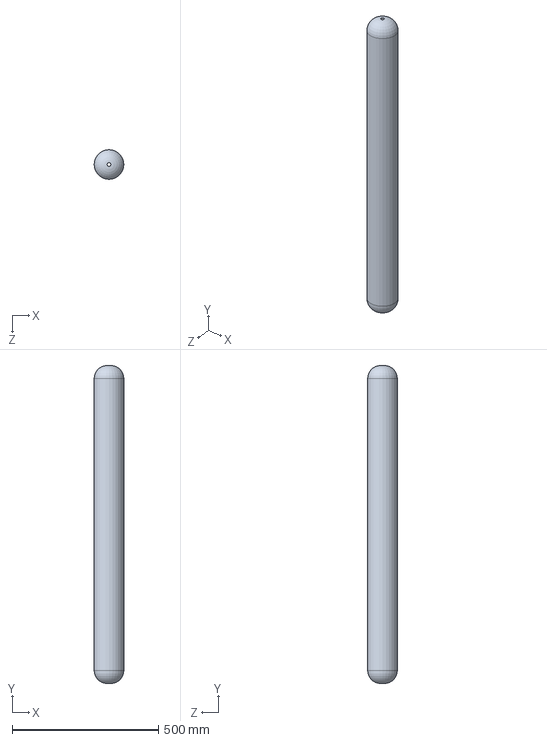
[picture p55: CAD file, 2019-07-26]
Example Mandrel.SLDPRT
101.6 x 1088.9 x 101.6 mm
