panatmospheric-voyage/filament-winder/Filament Pulley Injection Mold - Male.STL

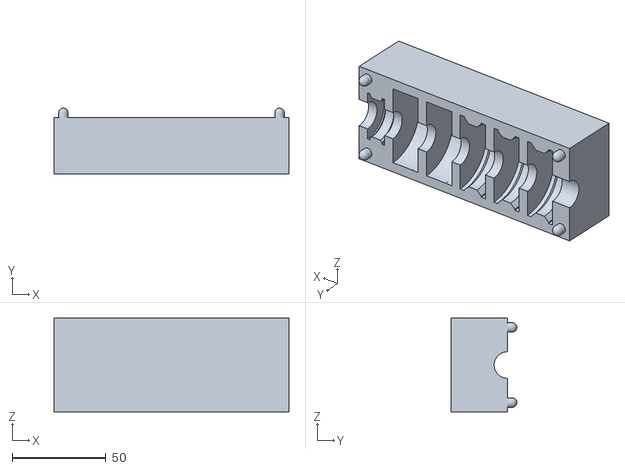
[picture p56: CAD file, 2019-07-26]
Filament Pulley Injection Mold - Male.STL
125.0 x 35.0 x 50.0
