panatmospheric-voyage/filament-winder/Heat Attachment.SLDPRT

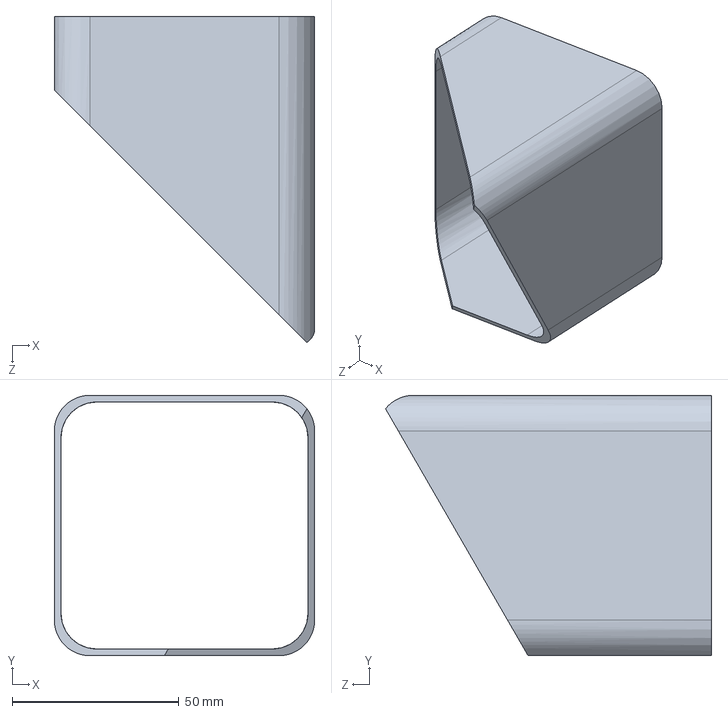
[picture p57: CAD file, 2019-07-26]
Heat Attachment.SLDPRT
78.0 x 78.0 x 97.7 mm
