panatmospheric-voyage/filament-winder/Filament Plate.SLDPRT

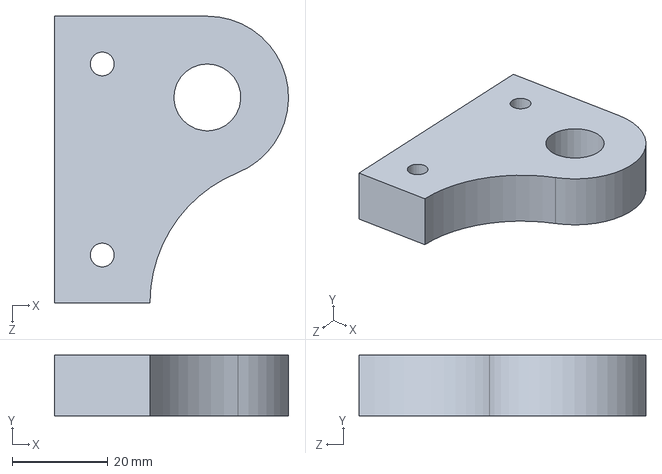
[picture p58: CAD file, 2019-07-26]
Filament Plate.SLDPRT
49.0 x 12.7 x 60.0 mm
