panatmospheric-voyage/filament-winder/Potentiometer PCB.SLDPRT

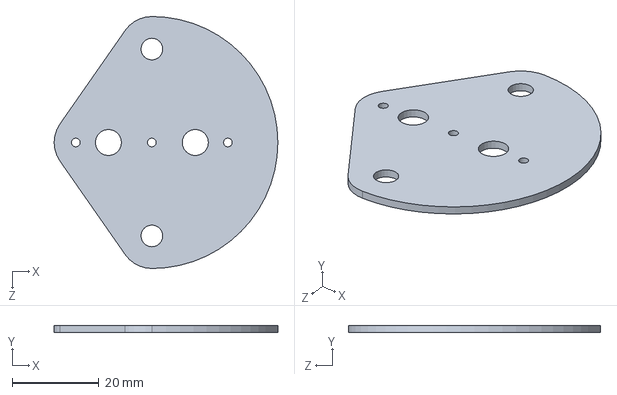
[picture p59: CAD file, 2019-07-26]
Potentiometer PCB.SLDPRT
51.5 x 1.60 x 58.0 mm
