panatmospheric-voyage/filament-winder/Axle.SLDPRT

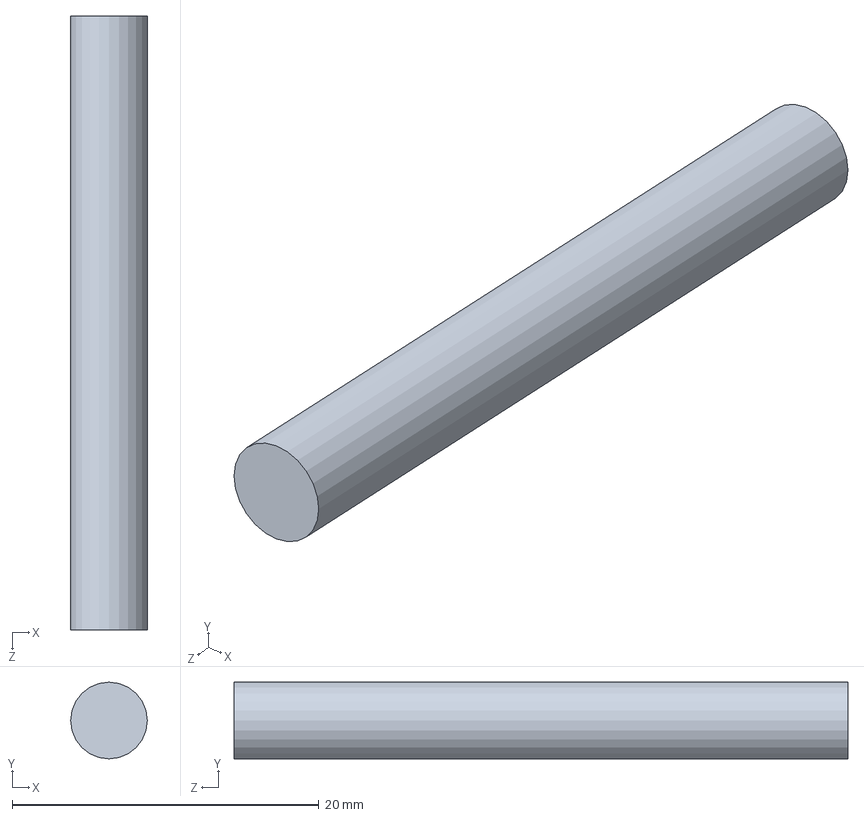
[picture p60: CAD file, 2019-07-26]
Axle.SLDPRT
5.00 x 5.00 x 40.0 mm
