panatmospheric-voyage/filament-winder/MDF 0.25in - Filament Winder - 1.DXF

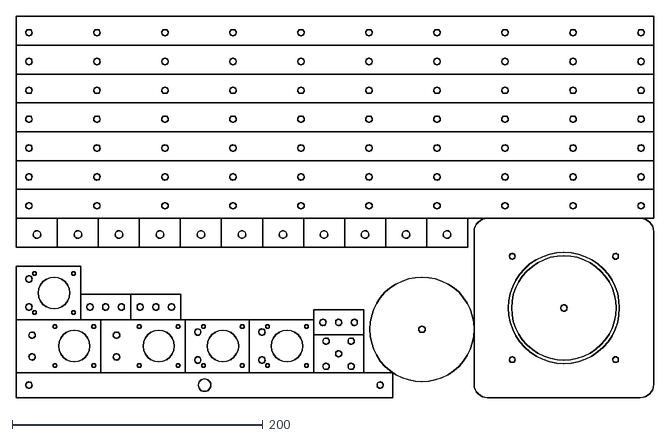
[picture p61: CAD file, 2019-07-26]
MDF 0.25in - Filament Winder - 1.DXF
508.0 x 304.0
