panatmospheric-voyage/filament-winder/Laser Sheet.SLDPRT

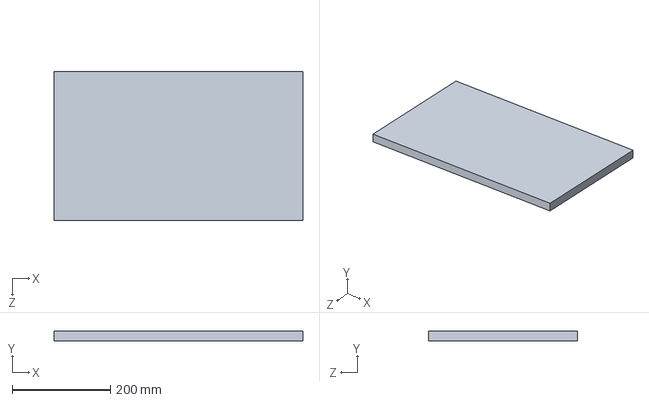
[picture p62: CAD file, 2019-07-26]
Laser Sheet.SLDPRT
508.0 x 20.0 x 304.8 mm
