panatmospheric-voyage/filament-winder/Pipe Plate.SLDPRT

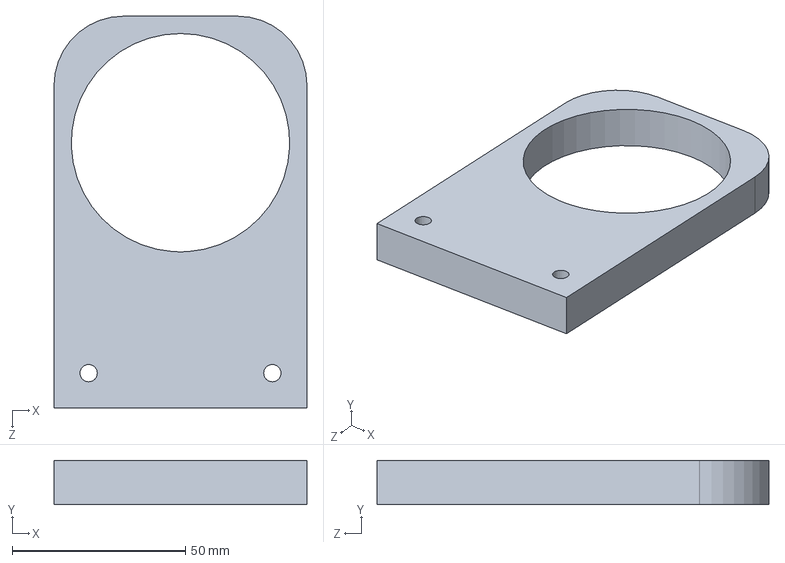
[picture p63: CAD file, 2019-07-26]
Pipe Plate.SLDPRT
73.0 x 12.7 x 113.0 mm
