panatmospheric-voyage/filament-winder/Fan.SLDPRT

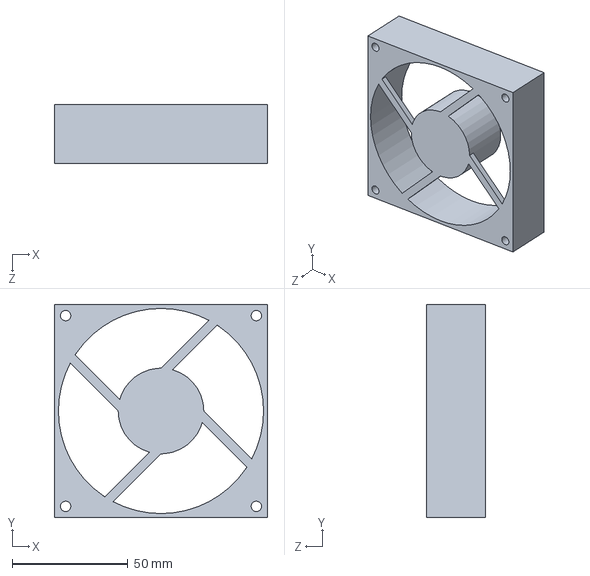
[picture p64: CAD file, 2019-07-26]
Fan.SLDPRT
92.0 x 92.0 x 25.3 mm
