panatmospheric-voyage/filament-winder/Clamp.SLDPRT

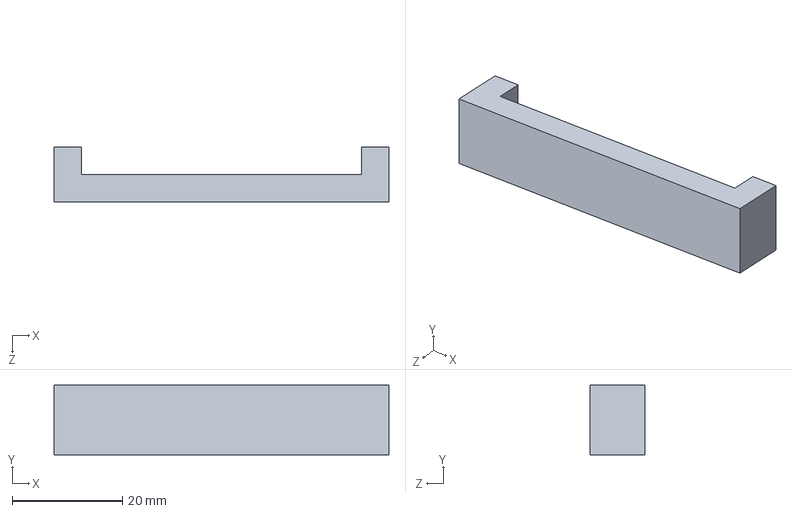
[picture p65: CAD file, 2019-07-26]
Clamp.SLDPRT
60.8 x 12.7 x 10.0 mm
