panatmospheric-voyage/filament-winder/(list of files, cad)

Other CAD files:
Belt Tool.STL
Bolt.SLDPRT
MDF 0.5in - Filament Winder - 2.DXF
PVC Quarter Jig.STL
