panatmospheric-voyage/filament-winder/Electronics/Rev 1.brd

## EAGLE design Electronics/Rev 1.brd (2019-07-28)

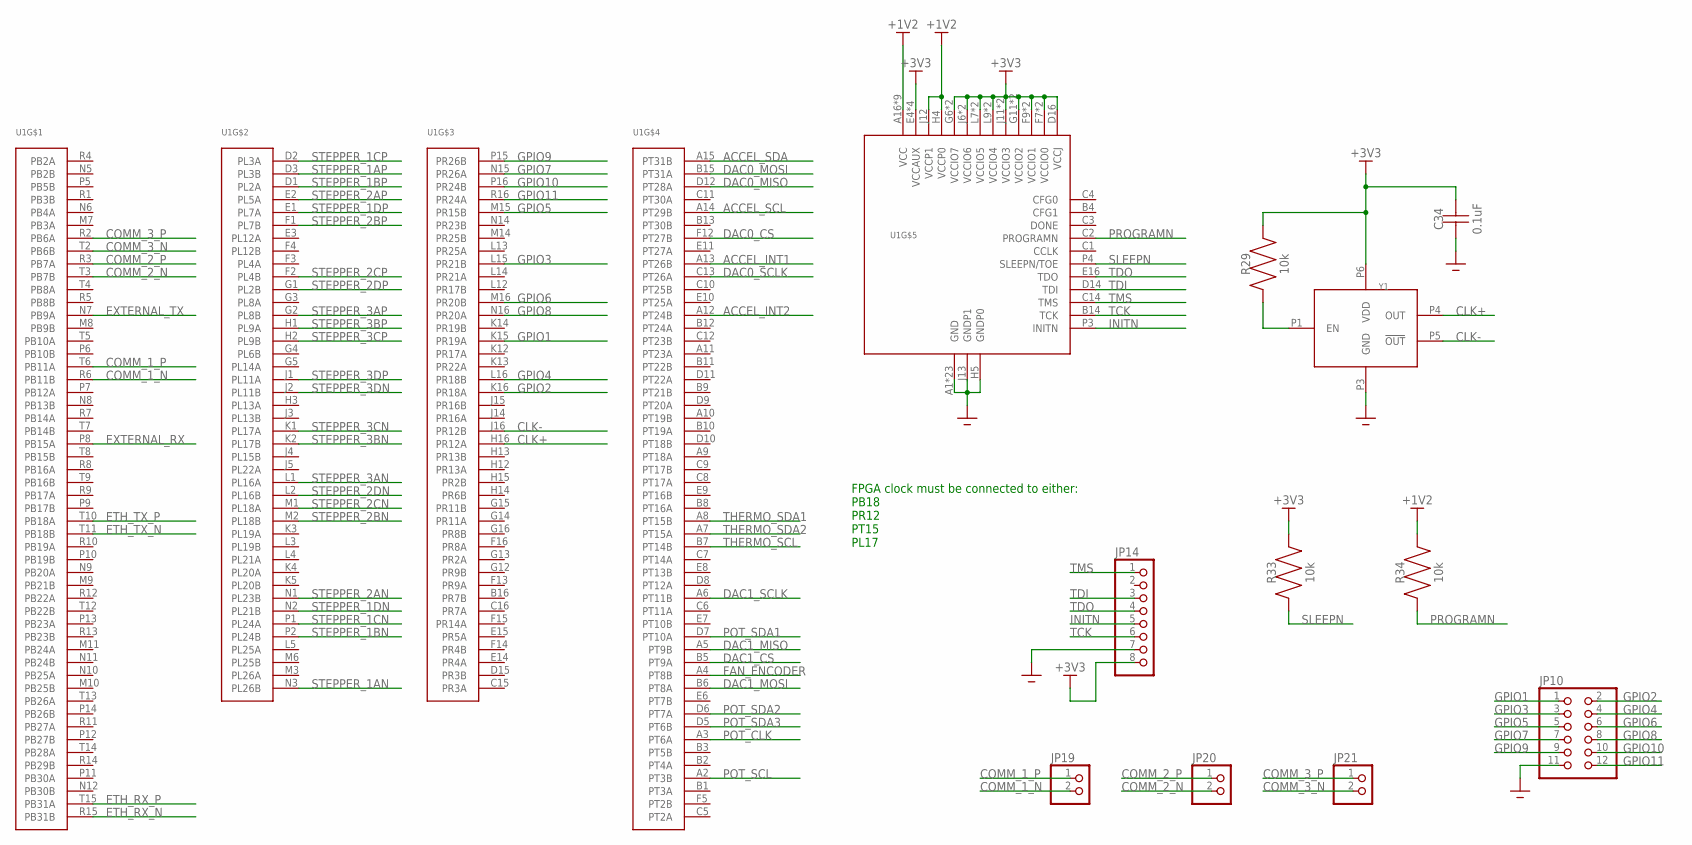
[picture p66: schematic Rev 1.sch, sheet 1, FPGA]

Parts:
C34: 0.1uF; 0805
JP10: PINHD-2X6; 2X06
JP14: PINHD-1X8; 1X08
JP19, JP20, JP21: PINHD-1X2; 1X02
R29, R33, R34: 10k; 0805
U1: LFXP6E-3FN256C; FBGA256
Y1: DSC1122B; ICDFN500X320X90-4

Connections:
+1V2: R34.P$2, U1.A16 (VCC), U1.D4 (VCC), U1.D13 (VCC), U1.E5 (VCC), U1.E12 (VCC), U1.H4 (VCCP0), U1.J12 (VCCP1), U1.M5 (VCC), U1.M12 (VCC), U1.N4 (VCC), U1.N13 (VCC); also elsewhere on the board
+3V3: C34.P$2, JP14.8, R29.P$2, R33.P$2, U1.D16 (VCCJ), U1.E4 (VCCAUX), U1.E13 (VCCAUX), U1.F7 (VCCIO0), U1.F8 (VCCIO0), U1.F9 (VCCIO1), U1.F10 (VCCIO1), U1.G6 (VCCIO7), U1.G11 (VCCIO2), U1.H6 (VCCIO7), U1.H11 (VCCIO2), U1.J6 (VCCIO6), U1.J11 (VCCIO3), U1.K6 (VCCIO6), U1.K11 (VCCIO3), U1.L7 (VCCIO5), U1.L8 (VCCIO5), U1.L9 (VCCIO4), U1.L10 (VCCIO4), U1.M4 (VCCAUX), U1.M13 (VCCAUX), Y1.P6 (VDD); also elsewhere on the board
ACCEL_INT1: U1.A13 (PT26B); also elsewhere on the board
ACCEL_INT2: U1.A12 (PT24B); also elsewhere on the board
ACCEL_SCL: U1.A14 (PT29B); also elsewhere on the board
ACCEL_SDA: U1.A15 (PT31B); also elsewhere on the board
CLK+: U1.H16 (PR12A), Y1.P4 (OUT)
CLK-: U1.J16 (PR12B), Y1.P5 (!OUT)
COMM_1_N: JP19.2, U1.R6 (PB11B)
COMM_1_P: JP19.1, U1.T6 (PB11A)
COMM_2_N: JP20.2, U1.T3 (PB7B)
COMM_2_P: JP20.1, U1.R3 (PB7A)
COMM_3_N: JP21.2, U1.T2 (PB6B)
COMM_3_P: JP21.1, U1.R2 (PB6A)
DAC0_CS: U1.F12 (PT27B); also elsewhere on the board
DAC0_MISO: U1.D12 (PT28A); also elsewhere on the board
DAC0_MOSI: U1.B15 (PT31A); also elsewhere on the board
DAC0_SCLK: U1.C13 (PT26A); also elsewhere on the board
DAC1_CS: U1.B5 (PT9A); also elsewhere on the board
DAC1_MISO: U1.A5 (PT9B); also elsewhere on the board
DAC1_MOSI: U1.B6 (PT8A); also elsewhere on the board
DAC1_SCLK: U1.A6 (PT11B); also elsewhere on the board
ETH_RX_N: U1.R15 (PB31B); also elsewhere on the board
ETH_RX_P: U1.T15 (PB31A); also elsewhere on the board
ETH_TX_N: U1.T11 (PB18B); also elsewhere on the board
ETH_TX_P: U1.T10 (PB18A); also elsewhere on the board
EXTERNAL_RX: U1.P8 (PB15A); also elsewhere on the board
EXTERNAL_TX: U1.N7 (PB9A); also elsewhere on the board
FAN_ENCODER: U1.A4 (PT8B); also elsewhere on the board
GND: C34.P$1, JP10.11, JP14.7, U1.A1 (GND), U1.F6 (GND), U1.F11 (GND), U1.G7 (GND), U1.G8 (GND), U1.G9 (GND), U1.G10 (GND), U1.H5 (GNDP0), U1.H7 (GND), U1.H8 (GND), U1.H9 (GND), U1.H10 (GND), U1.J7 (GND), U1.J8 (GND), U1.J9 (GND), U1.J10 (GND), U1.J13 (GNDP1), U1.K7 (GND), U1.K8 (GND), U1.K9 (GND), U1.K10 (GND), U1.L6 (GND), U1.L11 (GND), U1.T1 (GND), U1.T16 (GND), Y1.P3 (GND); also elsewhere on the board
GPIO1: JP10.1, U1.K15 (PR19A)
GPIO2: JP10.2, U1.K16 (PR18A)
GPIO3: JP10.3, U1.L15 (PR21B)
GPIO4: JP10.4, U1.L16 (PR18B)
GPIO5: JP10.5, U1.M15 (PR15B)
GPIO6: JP10.6, U1.M16 (PR20B)
GPIO7: JP10.7, U1.N15 (PR26A)
GPIO8: JP10.8, U1.N16 (PR20A)
GPIO9: JP10.9, U1.P15 (PR26B)
GPIO10: JP10.10, U1.P16 (PR24B)
GPIO11: JP10.12, U1.R16 (PR24A)
INITN: JP14.5, U1.P3 (INITN)
unnamed: R29.P$1, Y1.P1 (EN)
POT_CLK: U1.A3 (PT6A); also elsewhere on the board
POT_SCL: U1.A2 (PT3B); also elsewhere on the board
POT_SDA1: U1.D7 (PT10A); also elsewhere on the board
POT_SDA2: U1.D6 (PT7A); also elsewhere on the board
POT_SDA3: U1.D5 (PT6B); also elsewhere on the board
PROGRAMN: R34.P$1, U1.C2 (PROGRAMN)
SLEEPN: R33.P$1, U1.P4 (SLEEPN/TOE)
STEPPER_1AN: U1.N3 (PL26B); also elsewhere on the board
STEPPER_1AP: U1.D3 (PL3B); also elsewhere on the board
STEPPER_1BN: U1.P2 (PL24B); also elsewhere on the board
STEPPER_1BP: U1.D1 (PL2A); also elsewhere on the board
STEPPER_1CN: U1.P1 (PL24A); also elsewhere on the board
STEPPER_1CP: U1.D2 (PL3A); also elsewhere on the board
STEPPER_1DN: U1.N2 (PL21B); also elsewhere on the board
STEPPER_1DP: U1.E1 (PL7A); also elsewhere on the board
STEPPER_2AN: U1.N1 (PL23B); also elsewhere on the board
STEPPER_2AP: U1.E2 (PL5A); also elsewhere on the board
STEPPER_2BN: U1.M2 (PL18B); also elsewhere on the board
STEPPER_2BP: U1.F1 (PL7B); also elsewhere on the board
STEPPER_2CN: U1.M1 (PL18A); also elsewhere on the board
STEPPER_2CP: U1.F2 (PL4B); also elsewhere on the board
STEPPER_2DN: U1.L2 (PL16B); also elsewhere on the board
STEPPER_2DP: U1.G1 (PL2B); also elsewhere on the board
STEPPER_3AN: U1.L1 (PL16A); also elsewhere on the board
STEPPER_3AP: U1.G2 (PL8B); also elsewhere on the board
STEPPER_3BN: U1.K2 (PL17B); also elsewhere on the board
STEPPER_3BP: U1.H1 (PL9A); also elsewhere on the board
STEPPER_3CN: U1.K1 (PL17A); also elsewhere on the board
STEPPER_3CP: U1.H2 (PL9B); also elsewhere on the board
STEPPER_3DN: U1.J2 (PL11B); also elsewhere on the board
STEPPER_3DP: U1.J1 (PL11A); also elsewhere on the board
TCK: JP14.6, U1.B14 (TCK)
TDI: JP14.3, U1.D14 (TDI)
TDO: JP14.4, U1.E16 (TDO)
THERMO_SCL: U1.B7 (PT14B); also elsewhere on the board
THERMO_SDA1: U1.A8 (PT15B); also elsewhere on the board
THERMO_SDA2: U1.A7 (PT15A); also elsewhere on the board
TMS: JP14.1, U1.C14 (TMS)

Notes on the sheet:
FPGA clock must be connected to either: PB18 PR12 PT15 PL17

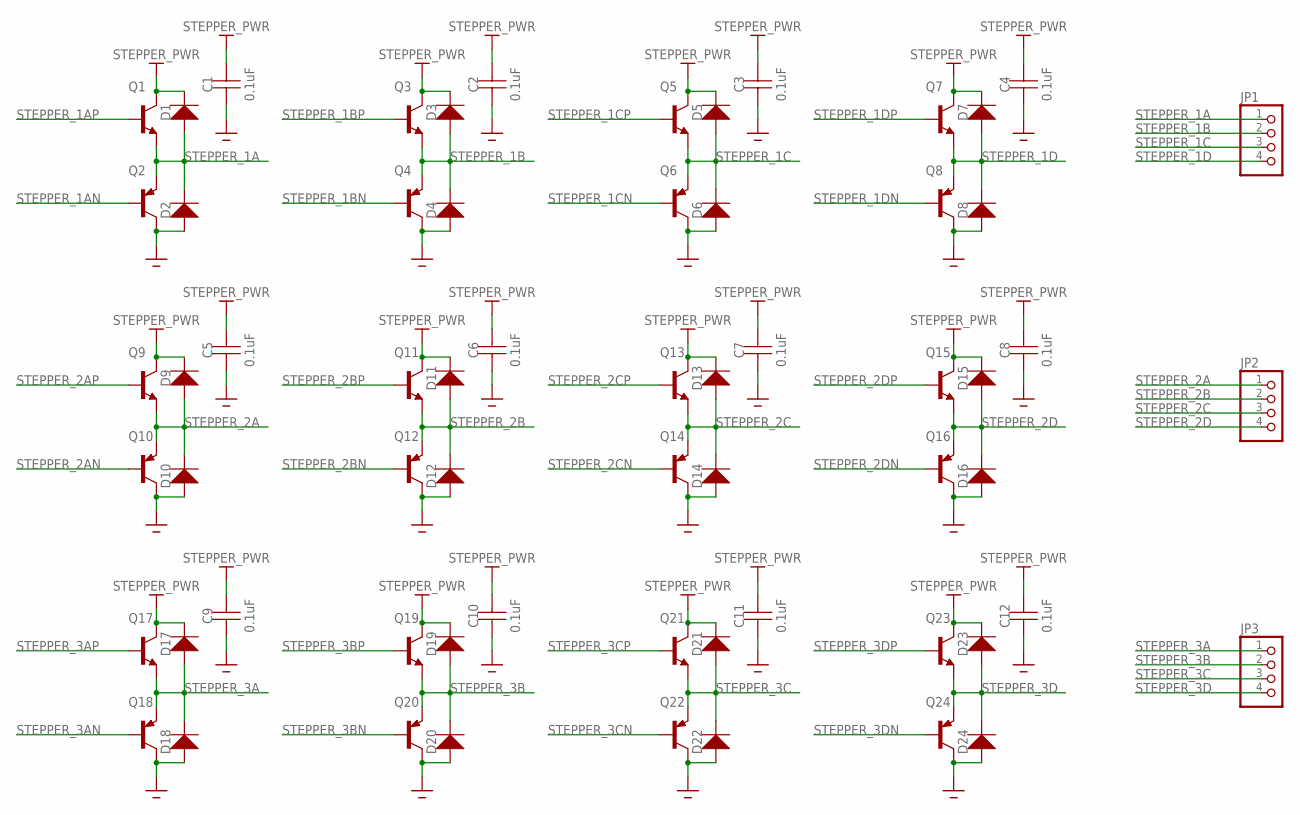
[picture p67: schematic Rev 1.sch, sheet 2, Stepper Drivers]

Parts:
C1, C2, C3, C4, C5, C6, C7, C8, C9, C10, C11, C12: 0.1uF; 0805
D1, D2, D3, D4, D5, D6, D7, D8, D9, D10, D11, D12, D13, D14, D15, D16, D17, D18, D19, D20, D21, D22, D23, D24: M7; DIOC5327X220
JP1, JP2, JP3: PINHD-1X4; 1X04
Q1, Q3, Q5, Q7, Q9, Q11, Q13, Q15, Q17, Q19, Q21, Q23: BCV27; SOT23-3
Q2, Q4, Q6, Q8, Q10, Q12, Q14, Q16, Q18, Q20, Q22, Q24: BCV26SOT23; SOT23-3

Connections:
GND: C1.P$1, C2.P$1, C3.P$1, C4.P$1, C5.P$1, C6.P$1, C7.P$1, C8.P$1, C9.P$1, C10.P$1, C11.P$1, C12.P$1, D2.1 (IN), D4.1 (IN), D6.1 (IN), D8.1 (IN), D10.1 (IN), D12.1 (IN), D14.1 (IN), D16.1 (IN), D18.1 (IN), D20.1 (IN), D22.1 (IN), D24.1 (IN), Q2.3 (C), Q4.3 (C), Q6.3 (C), Q8.3 (C), Q10.3 (C), Q12.3 (C), Q14.3 (C), Q16.3 (C), Q18.3 (C), Q20.3 (C), Q22.3 (C), Q24.3 (C); also elsewhere on the board
STEPPER_1A: D1.1 (IN), D2.2 (OUT), JP1.1, Q1.2 (E), Q2.2 (E)
STEPPER_1AN: Q2.1 (B); also elsewhere on the board
STEPPER_1AP: Q1.1 (B); also elsewhere on the board
STEPPER_1B: D3.1 (IN), D4.2 (OUT), JP1.2, Q3.2 (E), Q4.2 (E)
STEPPER_1BN: Q4.1 (B); also elsewhere on the board
STEPPER_1BP: Q3.1 (B); also elsewhere on the board
STEPPER_1C: D5.1 (IN), D6.2 (OUT), JP1.3, Q5.2 (E), Q6.2 (E)
STEPPER_1CN: Q6.1 (B); also elsewhere on the board
STEPPER_1CP: Q5.1 (B); also elsewhere on the board
STEPPER_1D: D7.1 (IN), D8.2 (OUT), JP1.4, Q7.2 (E), Q8.2 (E)
STEPPER_1DN: Q8.1 (B); also elsewhere on the board
STEPPER_1DP: Q7.1 (B); also elsewhere on the board
STEPPER_2A: D9.1 (IN), D10.2 (OUT), JP2.1, Q9.2 (E), Q10.2 (E)
STEPPER_2AN: Q10.1 (B); also elsewhere on the board
STEPPER_2AP: Q9.1 (B); also elsewhere on the board
STEPPER_2B: D11.1 (IN), D12.2 (OUT), JP2.2, Q11.2 (E), Q12.2 (E)
STEPPER_2BN: Q12.1 (B); also elsewhere on the board
STEPPER_2BP: Q11.1 (B); also elsewhere on the board
STEPPER_2C: D13.1 (IN), D14.2 (OUT), JP2.3, Q13.2 (E), Q14.2 (E)
STEPPER_2CN: Q14.1 (B); also elsewhere on the board
STEPPER_2CP: Q13.1 (B); also elsewhere on the board
STEPPER_2D: D15.1 (IN), D16.2 (OUT), JP2.4, Q15.2 (E), Q16.2 (E)
STEPPER_2DN: Q16.1 (B); also elsewhere on the board
STEPPER_2DP: Q15.1 (B); also elsewhere on the board
STEPPER_3A: D17.1 (IN), D18.2 (OUT), JP3.1, Q17.2 (E), Q18.2 (E)
STEPPER_3AN: Q18.1 (B); also elsewhere on the board
STEPPER_3AP: Q17.1 (B); also elsewhere on the board
STEPPER_3B: D19.1 (IN), D20.2 (OUT), JP3.2, Q19.2 (E), Q20.2 (E)
STEPPER_3BN: Q20.1 (B); also elsewhere on the board
STEPPER_3BP: Q19.1 (B); also elsewhere on the board
STEPPER_3C: D21.1 (IN), D22.2 (OUT), JP3.3, Q21.2 (E), Q22.2 (E)
STEPPER_3CN: Q22.1 (B); also elsewhere on the board
STEPPER_3CP: Q21.1 (B); also elsewhere on the board
STEPPER_3D: D23.1 (IN), D24.2 (OUT), JP3.4, Q23.2 (E), Q24.2 (E)
STEPPER_3DN: Q24.1 (B); also elsewhere on the board
STEPPER_3DP: Q23.1 (B); also elsewhere on the board
STEPPER_PWR: C1.P$2, C2.P$2, C3.P$2, C4.P$2, C5.P$2, C6.P$2, C7.P$2, C8.P$2, C9.P$2, C10.P$2, C11.P$2, C12.P$2, D1.2 (OUT), D3.2 (OUT), D5.2 (OUT), D7.2 (OUT), D9.2 (OUT), D11.2 (OUT), D13.2 (OUT), D15.2 (OUT), D17.2 (OUT), D19.2 (OUT), D21.2 (OUT), D23.2 (OUT), Q1.3 (C), Q3.3 (C), Q5.3 (C), Q7.3 (C), Q9.3 (C), Q11.3 (C), Q13.3 (C), Q15.3 (C), Q17.3 (C), Q19.3 (C), Q21.3 (C), Q23.3 (C); also elsewhere on the board

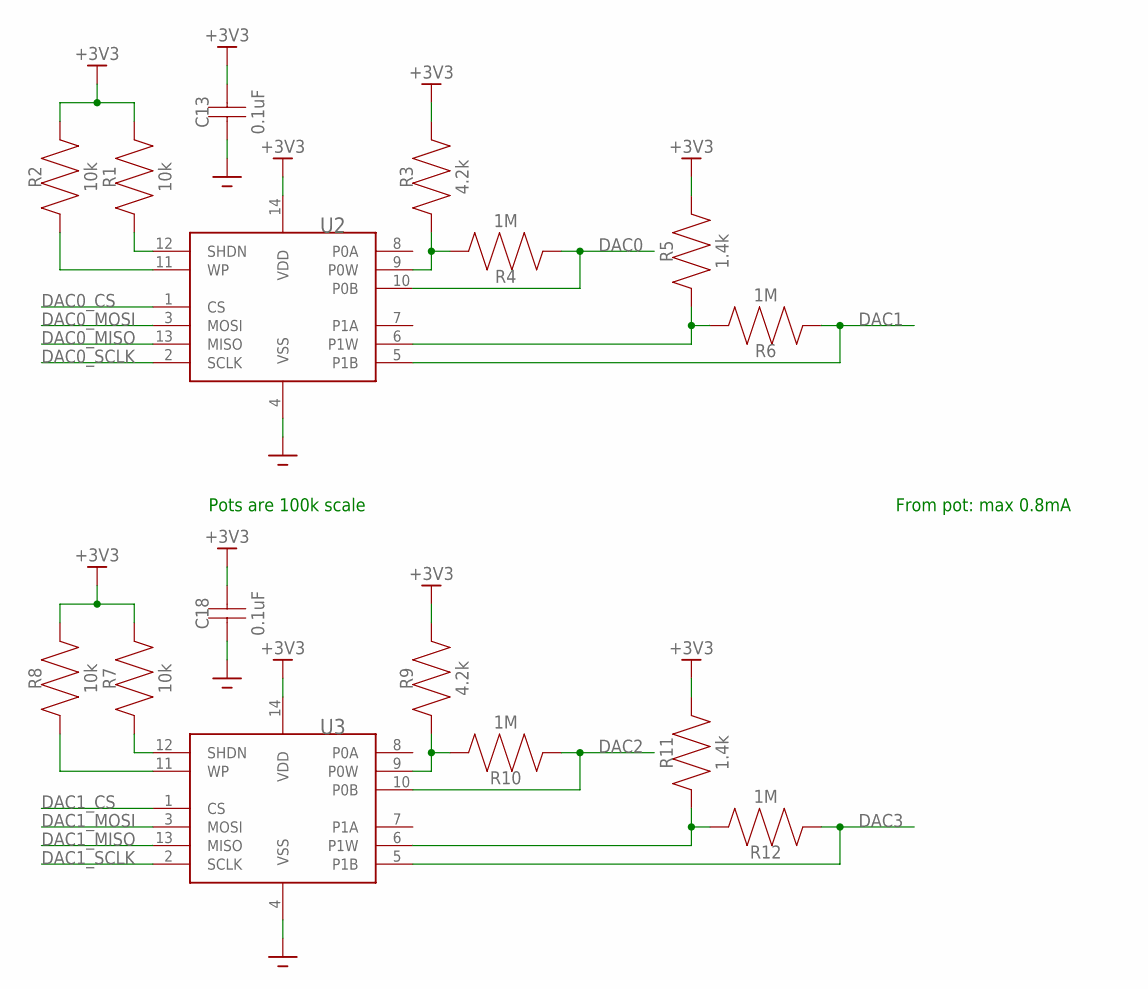
[picture p68: schematic Rev 1.sch, sheet 3, DAC]

Parts:
C13, C18: 0.1uF; 0805
R1, R2, R7, R8: 10k; 0805
R3, R9: 4.2k; 0805
R4, R6, R10, R12: 1M; 0805
R5, R11: 1.4k; 0805
U2, U3: MCP4251; SOP65P640X120-14

Connections:
+3V3: C13.P$2, C18.P$2, R1.P$2, R2.P$2, R3.P$2, R5.P$2, R7.P$2, R8.P$2, R9.P$2, R11.P$2, U2.14 (VDD), U3.14 (VDD); also elsewhere on the board
DAC0: R4.P$1, U2.10 (P0B); also elsewhere on the board
DAC0_CS: U2.1 (CS); also elsewhere on the board
DAC0_MISO: U2.13 (MISO); also elsewhere on the board
DAC0_MOSI: U2.3 (MOSI); also elsewhere on the board
DAC0_SCLK: U2.2 (SCLK); also elsewhere on the board
DAC1: R6.P$1, U2.5 (P1B); also elsewhere on the board
DAC1_CS: U3.1 (CS); also elsewhere on the board
DAC1_MISO: U3.13 (MISO); also elsewhere on the board
DAC1_MOSI: U3.3 (MOSI); also elsewhere on the board
DAC1_SCLK: U3.2 (SCLK); also elsewhere on the board
DAC2: R10.P$1, U3.10 (P0B); also elsewhere on the board
DAC3: R12.P$1, U3.5 (P1B); also elsewhere on the board
GND: C13.P$1, C18.P$1, U2.4 (VSS), U3.4 (VSS); also elsewhere on the board
unnamed: R1.P$1, U2.12 (SHDN)
unnamed: R2.P$1, U2.11 (WP)
unnamed: R3.P$1, R4.P$2, U2.9 (P0W)
unnamed: R5.P$1, R6.P$2, U2.6 (P1W)
unnamed: R7.P$1, U3.12 (SHDN)
unnamed: R8.P$1, U3.11 (WP)
unnamed: R9.P$1, R10.P$2, U3.9 (P0W)
unnamed: R11.P$1, R12.P$2, U3.6 (P1W)

Notes on the sheet:
From pot: max 0.8mA
Pots are 100k scale

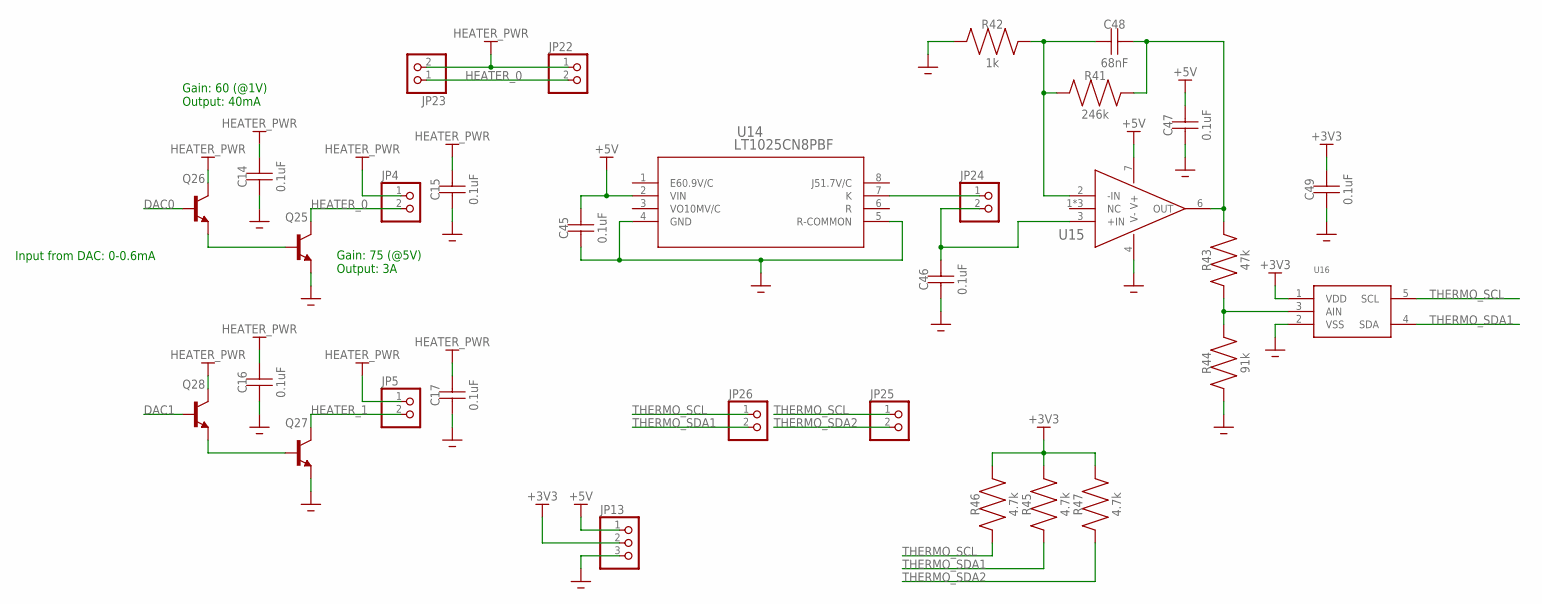
[picture p69: schematic Rev 1.sch, sheet 4, Heating Elements]

Parts:
C14, C15, C16, C17, C45, C46, C47, C49: 0.1uF; 0805
C48: 68nF; 0805
JP4, JP5, JP22, JP23, JP24, JP25, JP26: PINHD-1X2; 1X02
JP13: PINHD-1X3; 1X03
Q25, Q27: PBSS4360XFPBSS4360XF; SOT150P400X160-4
Q26, Q28: MMBT3904,215MMBT3904,215; SOT95P230X110-3
R41: 246k; 0805
R42: 1k; 0805
R43: 47k; 0805
R44: 91k; 0805
R45, R46, R47: 4.7k; 0805
U14: LT1025CN8PBF; N_8
U15: LTC1049CS8#PBF; SO-8_S
U16: MCP3021A1T-E/OTSOT23; SOT23-5

Connections:
+3V3: C49.P$2, JP13.2, R45.P$2, R46.P$2, R47.P$2, U16.1 (VDD); also elsewhere on the board
+5V: C45.P$2, C47.P$2, JP13.1, U14.2 (VIN), U15.7 (V+); also elsewhere on the board
DAC0: Q26.1 (B); also elsewhere on the board
DAC1: Q28.1 (B); also elsewhere on the board
GND: C14.P$1, C15.P$1, C16.P$1, C17.P$1, C45.P$1, C46.P$1, C47.P$1, C49.P$1, JP13.3, Q25.1 (E), Q27.1 (E), R42.P$1, R44.P$1, U14.4 (GND), U14.5 (R-COMMON), U15.4 (V-), U16.2 (VSS); also elsewhere on the board
HEATER_0: JP4.2, JP22.2, JP23.1, Q25.2 (C), Q25.4 (C)
HEATER_1: JP5.2, Q27.2 (C), Q27.4 (C)
HEATER_PWR: C14.P$2, C15.P$2, C16.P$2, C17.P$2, JP4.1, JP5.1, JP22.1, JP23.2, Q26.3 (C), Q28.3 (C); also elsewhere on the board
unnamed: Q25.3 (B), Q26.2 (E)
unnamed: Q27.3 (B), Q28.2 (E)
unnamed: C46.P$2, JP24.2, U15.3 (+IN)
unnamed: C48.P$1, R41.P$1, R42.P$2, U15.2 (-IN)
unnamed: JP24.1, U14.7 (K)
unnamed: C48.P$2, R41.P$2, R43.P$2, U15.6 (OUT)
unnamed: R43.P$1, R44.P$2, U16.3 (AIN)
THERMO_SCL: JP25.1, JP26.1, R46.P$1, U16.5 (SCL); also elsewhere on the board
THERMO_SDA1: JP26.2, R45.P$1, U16.4 (SDA); also elsewhere on the board
THERMO_SDA2: JP25.2, R47.P$1; also elsewhere on the board

Notes on the sheet:
Gain: 75 (@5V) Output: 3A
Gain: 60 (@1V) Output: 40mA
Input from DAC: 0-0.6mA

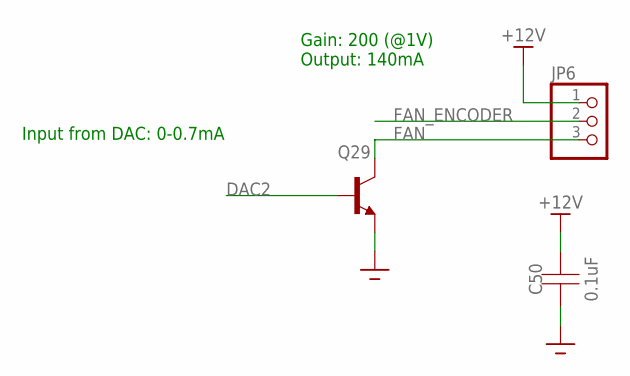
[picture p70: schematic Rev 1.sch, sheet 5, Fan]

Parts:
C50: 0.1uF; 0805
JP6: PINHD-1X3; 1X03
Q29: PBSS4360XFPBSS4360XF; SOT150P400X160-4

Connections:
+12V: C50.P$2, JP6.1; also elsewhere on the board
DAC2: Q29.3 (B); also elsewhere on the board
FAN: JP6.3, Q29.2 (C), Q29.4 (C)
FAN_ENCODER: JP6.2; also elsewhere on the board
GND: C50.P$1, Q29.1 (E); also elsewhere on the board

Notes on the sheet:
Gain: 200 (@1V) Output: 140mA
Input from DAC: 0-0.7mA

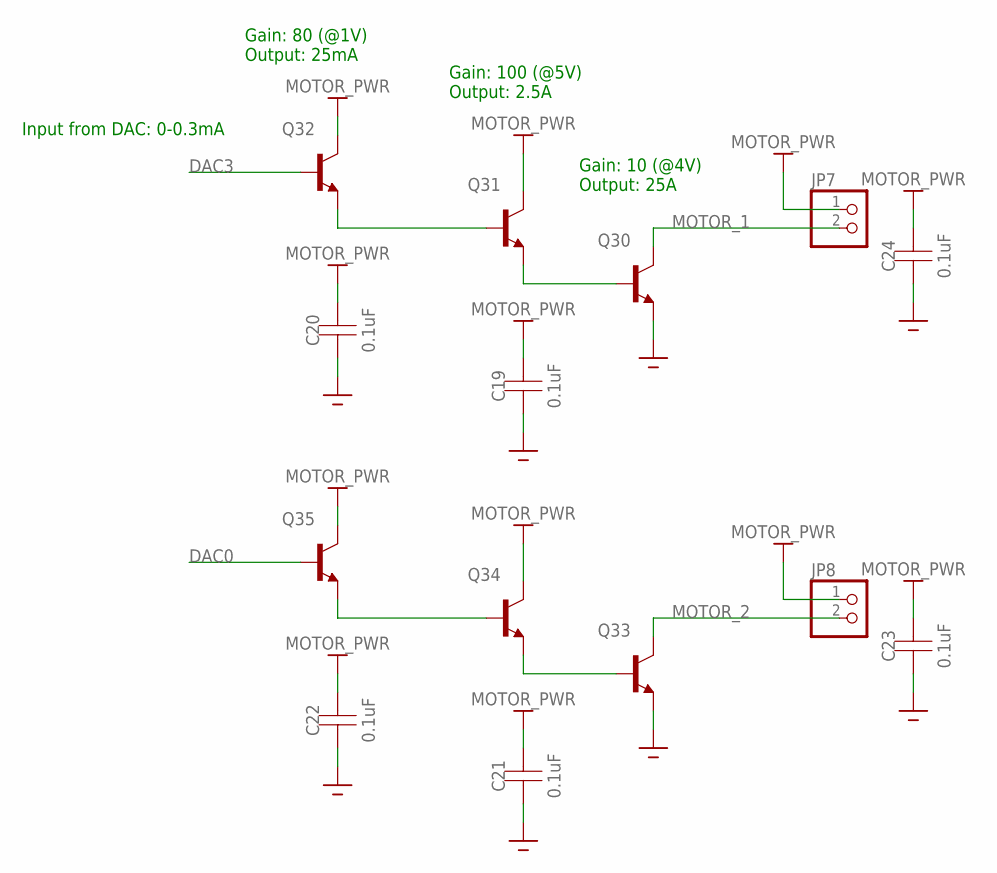
[picture p71: schematic Rev 1.sch, sheet 6, DC Motors]

Parts:
C19, C20, C21, C22, C23, C24: 0.1uF; 0805
JP7, JP8: PINHD-1X2; 1X02
Q30, Q33: TIP35CTIP35C; HDRV3W140P545_1X3_1560X508X838B
Q31, Q34: PBSS4360XFPBSS4360XF; SOT150P400X160-4
Q32, Q35: MMBT3904,215MMBT3904,215; SOT95P230X110-3

Connections:
DAC0: Q35.1 (B); also elsewhere on the board
DAC3: Q32.1 (B); also elsewhere on the board
GND: C19.P$1, C20.P$1, C21.P$1, C22.P$1, C23.P$1, C24.P$1, Q30.3 (E), Q33.3 (E); also elsewhere on the board
MOTOR_1: JP7.2, Q30.2 (C)
MOTOR_2: JP8.2, Q33.2 (C)
MOTOR_PWR: C19.P$2, C20.P$2, C21.P$2, C22.P$2, C23.P$2, C24.P$2, JP7.1, JP8.1, Q31.2 (C), Q31.4 (C), Q32.3 (C), Q34.2 (C), Q34.4 (C), Q35.3 (C); also elsewhere on the board
unnamed: Q33.1 (B), Q34.1 (E)
unnamed: Q30.1 (B), Q31.1 (E)
unnamed: Q31.3 (B), Q32.2 (E)
unnamed: Q34.3 (B), Q35.2 (E)

Notes on the sheet:
Gain: 10 (@4V) Output: 25A
Gain: 100 (@5V) Output: 2.5A
Gain: 80 (@1V) Output: 25mA
Input from DAC: 0-0.3mA

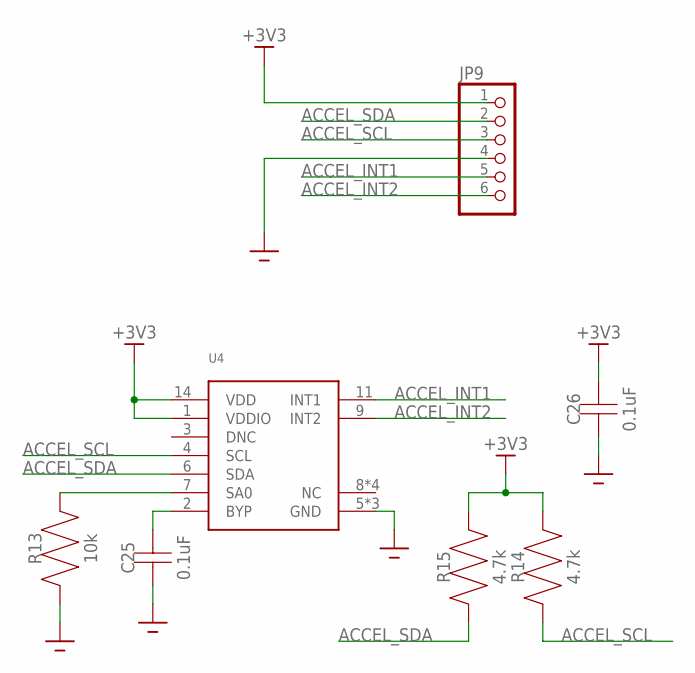
[picture p72: schematic Rev 1.sch, sheet 7, Accelerometer]

Parts:
C25, C26: 0.1uF; 0805
JP9: PINHD-1X6; 1X06
R13: 10k; 0805
R14, R15: 4.7k; 0805
U4: MMA8453QR116QFN; 16QFN

Connections:
+3V3: C26.P$2, JP9.1, R14.P$2, R15.P$2, U4.1 (VDDIO), U4.14 (VDD); also elsewhere on the board
ACCEL_INT1: JP9.5, U4.11 (INT1); also elsewhere on the board
ACCEL_INT2: JP9.6, U4.9 (INT2); also elsewhere on the board
ACCEL_SCL: JP9.3, R14.P$1, U4.4 (SCL); also elsewhere on the board
ACCEL_SDA: JP9.2, R15.P$1, U4.6 (SDA); also elsewhere on the board
GND: C25.P$1, C26.P$1, JP9.4, R13.P$1, U4.5 (GND), U4.10 (GND), U4.12 (GND); also elsewhere on the board
unnamed: C25.P$2, U4.2 (BYP)
unnamed: R13.P$2, U4.7 (SA0)

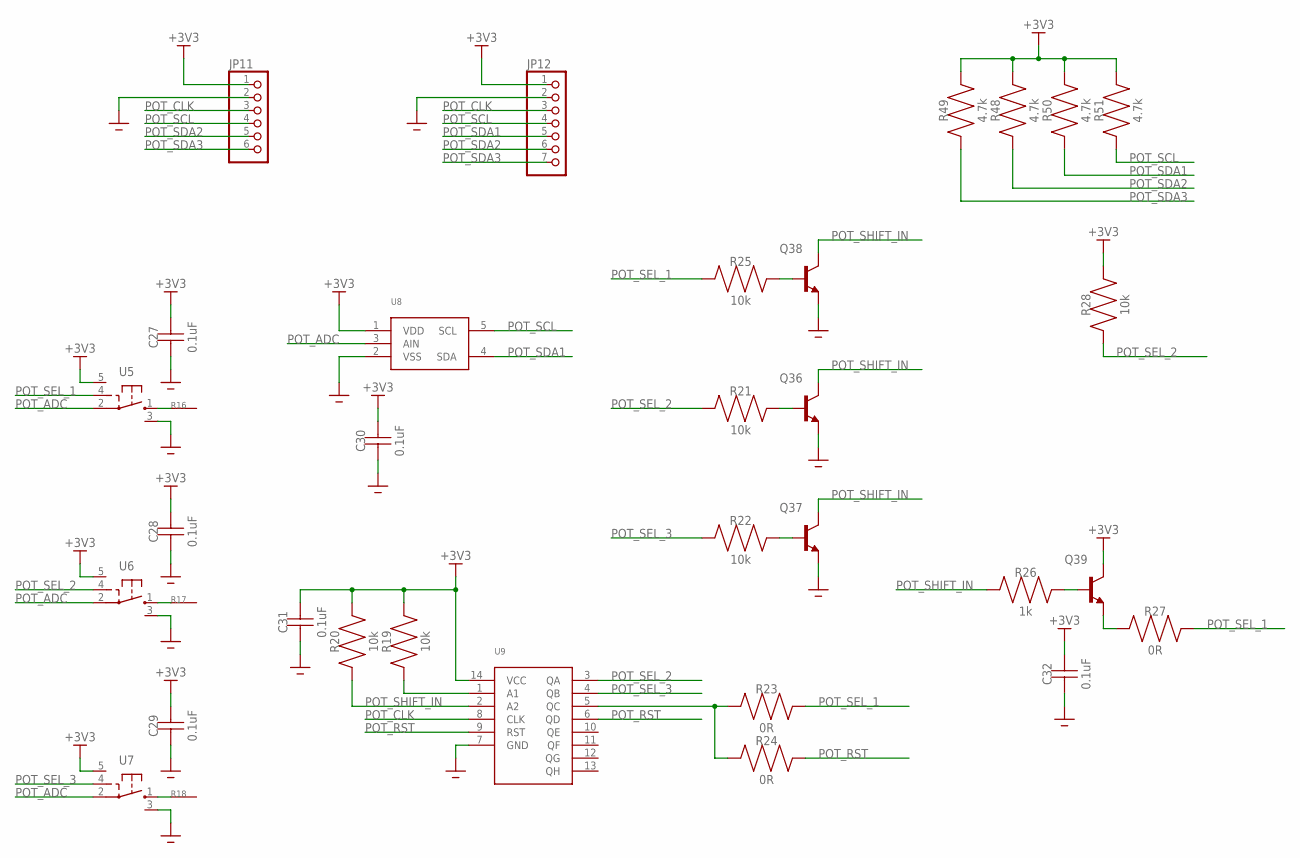
[picture p73: schematic Rev 1.sch, sheet 8, Potentiometers]

Parts:
C27, C28, C29, C30, C31, C32: 0.1uF; 0805
JP11: PINHD-1X6; 1X06
JP12: PINHD-1X7; 1X07
Q36, Q37, Q38, Q39: MMBT3904,215MMBT3904,215; SOT95P230X110-3
R16, R17, R18: POTENTIOMETER
R19, R20, R21, R22, R25, R28: 10k; 0805
R23, R24, R27: 0R; 0805
R26: 1k; 0805
R48, R49, R50, R51: 4.7k; 0805
U5, U6, U7: 74AHC1G66GW,125TSSOP6; TSSOP5
U8: MCP3021A1T-E/OTSOT23; SOT23-5
U9: MC74HC164BDR2GMC74HC164BDR2G; SOIC127P600X175-14

Connections:
+3V3: C27.P$2, C28.P$2, C29.P$2, C30.P$2, C31.P$2, C32.P$2, JP11.1, JP12.1, Q39.3 (C), R19.P$2, R20.P$2, R28.P$2, R48.P$2, R49.P$2, R50.P$2, R51.P$2, U5.5 (VCC), U6.5 (VCC), U7.5 (VCC), U8.1 (VDD), U9.14 (VCC); also elsewhere on the board
GND: C27.P$1, C28.P$1, C29.P$1, C30.P$1, C31.P$1, C32.P$1, JP11.2, JP12.2, Q36.2 (E), Q37.2 (E), Q38.2 (E), U5.3 (GND), U6.3 (GND), U7.3 (GND), U8.2 (VSS), U9.7 (GND); also elsewhere on the board
unnamed: R16.P$1, U5.1 (Y)
unnamed: R17.P$1, U6.1 (Y)
unnamed: R18.P$1, U7.1 (Y)
unnamed: Q36.1 (B), R21.P$2
unnamed: R19.P$1, U9.1 (A1)
unnamed: Q37.1 (B), R22.P$2
unnamed: R23.P$1, R24.P$1, U9.5 (QC)
unnamed: Q38.1 (B), R25.P$2
unnamed: Q39.1 (B), R26.P$2
unnamed: Q39.2 (E), R27.P$1
POT_ADC: U5.2 (Z), U6.2 (Z), U7.2 (Z), U8.3 (AIN)
POT_CLK: JP11.3, JP12.3, U9.8 (CLK); also elsewhere on the board
POT_RST: R24.P$2, U9.6 (QD), U9.9 (RST)
POT_SCL: JP11.4, JP12.4, R51.P$1, U8.5 (SCL); also elsewhere on the board
POT_SDA1: JP12.5, R50.P$1, U8.4 (SDA); also elsewhere on the board
POT_SDA2: JP11.5, JP12.6, R48.P$1; also elsewhere on the board
POT_SDA3: JP11.6, JP12.7, R49.P$1; also elsewhere on the board
POT_SEL_1: R23.P$2, R25.P$1, R27.P$2, U5.4 (E)
POT_SEL_2: R21.P$1, R28.P$1, U6.4 (E), U9.3 (QA)
POT_SEL_3: R22.P$1, U7.4 (E), U9.4 (QB)
POT_SHIFT_IN: Q36.3 (C), Q37.3 (C), Q38.3 (C), R20.P$1, R26.P$1, U9.2 (A2)

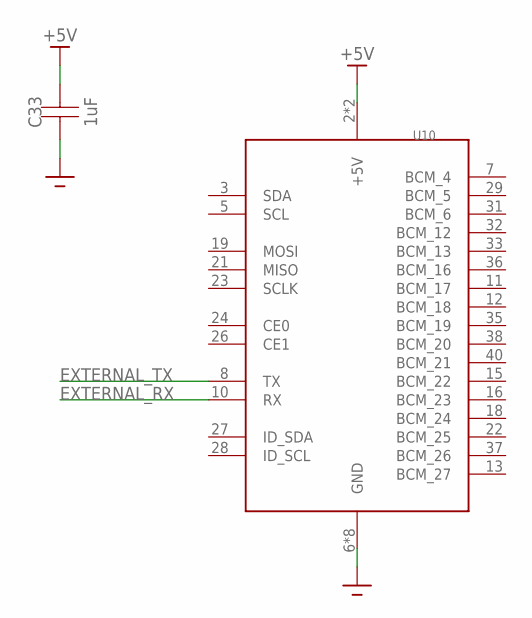
[picture p74: schematic Rev 1.sch, sheet 9, Raspberry Pi Interface]

Parts:
C33: 1uF; 0805
U10: RPI

Connections:
+5V: C33.P$2, U10.2 (+5V), U10.4 (+5V); also elsewhere on the board
EXTERNAL_RX: U10.10 (RX); also elsewhere on the board
EXTERNAL_TX: U10.8 (TX); also elsewhere on the board
GND: C33.P$1, U10.6 (GND), U10.9 (GND), U10.14 (GND), U10.20 (GND), U10.25 (GND), U10.30 (GND), U10.34 (GND), U10.39 (GND); also elsewhere on the board

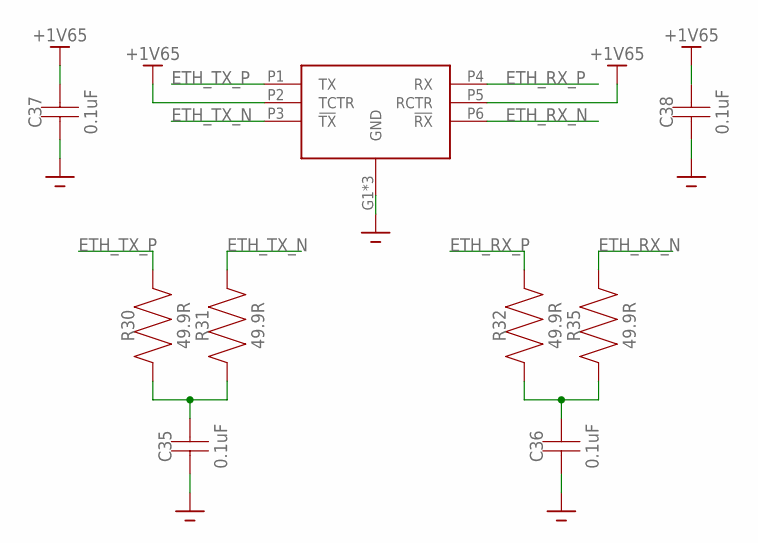
[picture p75: schematic Rev 1.sch, sheet 10, Ethernet]

Parts:
C35, C36, C37, C38: 0.1uF; 0805
P1: 5-2301994-4
R30, R31, R32, R35: 49.9R; 0805

Connections:
+1V65: C37.P$2, C38.P$2, P1.P2 (TCTR), P1.P5 (RCTR); also elsewhere on the board
ETH_RX_N: P1.P6 (!RX), R35.P$2; also elsewhere on the board
ETH_RX_P: P1.P4 (RX), R32.P$2; also elsewhere on the board
ETH_TX_N: P1.P3 (!TX), R31.P$2; also elsewhere on the board
ETH_TX_P: P1.P1 (TX), R30.P$2; also elsewhere on the board
GND: C35.P$1, C36.P$1, C37.P$1, C38.P$1, P1.G1 (GND), P1.G2 (GND), P1.P8 (GND); also elsewhere on the board
unnamed: C35.P$2, R30.P$1, R31.P$1
unnamed: C36.P$2, R32.P$1, R35.P$1

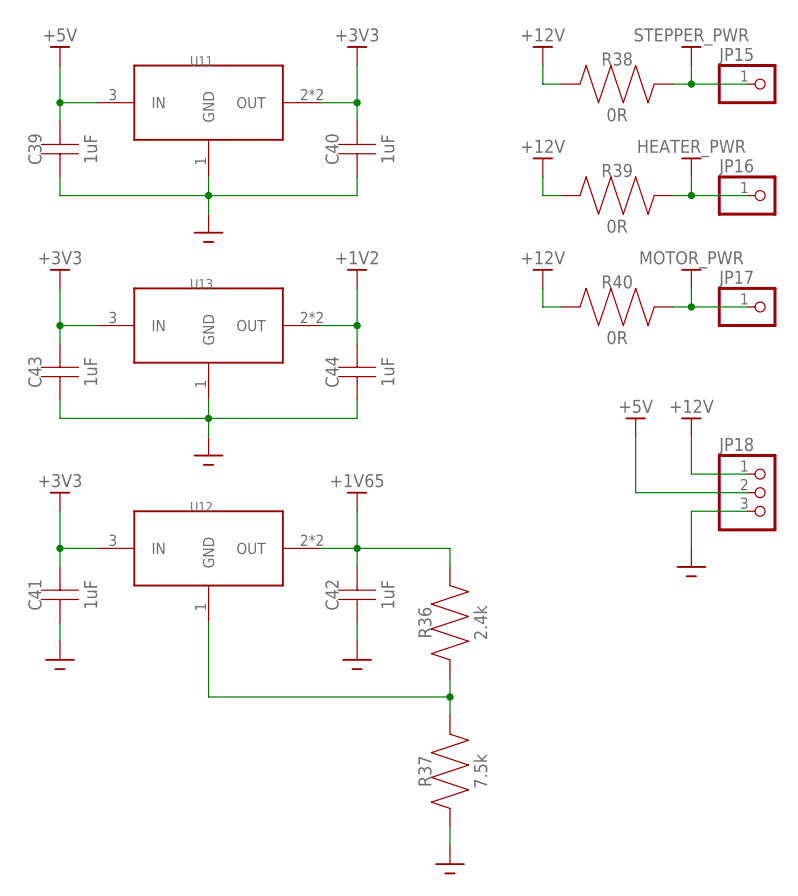
[picture p76: schematic Rev 1.sch, sheet 11, Power]

Parts:
C39, C40, C41, C42, C43, C44: 1uF; 0805
JP15, JP16, JP17: PINHD-1X1; 1X01
JP18: PINHD-1X3; 1X03
R36: 2.4k; 0805
R37: 7.5k; 0805
R38, R39, R40: 0R; 0805
U11, U12, U13: 3.3V; SOT230P700X180-4

Connections:
+1V2: C44.P$2, U13.2 (OUT), U13.4 (OUT); also elsewhere on the board
+1V65: C42.P$2, R36.P$2, U12.2 (OUT), U12.4 (OUT); also elsewhere on the board
+3V3: C40.P$2, C41.P$2, C43.P$2, U11.2 (OUT), U11.4 (OUT), U12.3 (IN), U13.3 (IN); also elsewhere on the board
+5V: C39.P$2, JP18.2, U11.3 (IN); also elsewhere on the board
+12V: JP18.1, R38.P$1, R39.P$1, R40.P$1; also elsewhere on the board
GND: C39.P$1, C40.P$1, C41.P$1, C42.P$1, C43.P$1, C44.P$1, JP18.3, R37.P$1, U11.1 (GND), U13.1 (GND); also elsewhere on the board
HEATER_PWR: JP16.1, R39.P$2; also elsewhere on the board
MOTOR_PWR: JP17.1, R40.P$2; also elsewhere on the board
unnamed: R36.P$1, R37.P$2, U12.1 (GND)
STEPPER_PWR: JP15.1, R38.P$2; also elsewhere on the board

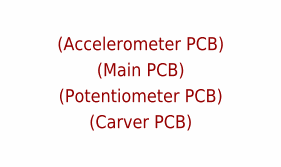
[picture p77: schematic Rev 1.sch, sheet 12, Meta Symbols]

Parts:
U$1: PCB_ACCEL
U$2: PCB_MAIN
U$3: PCB_POT
U$4: PCB_CARVER

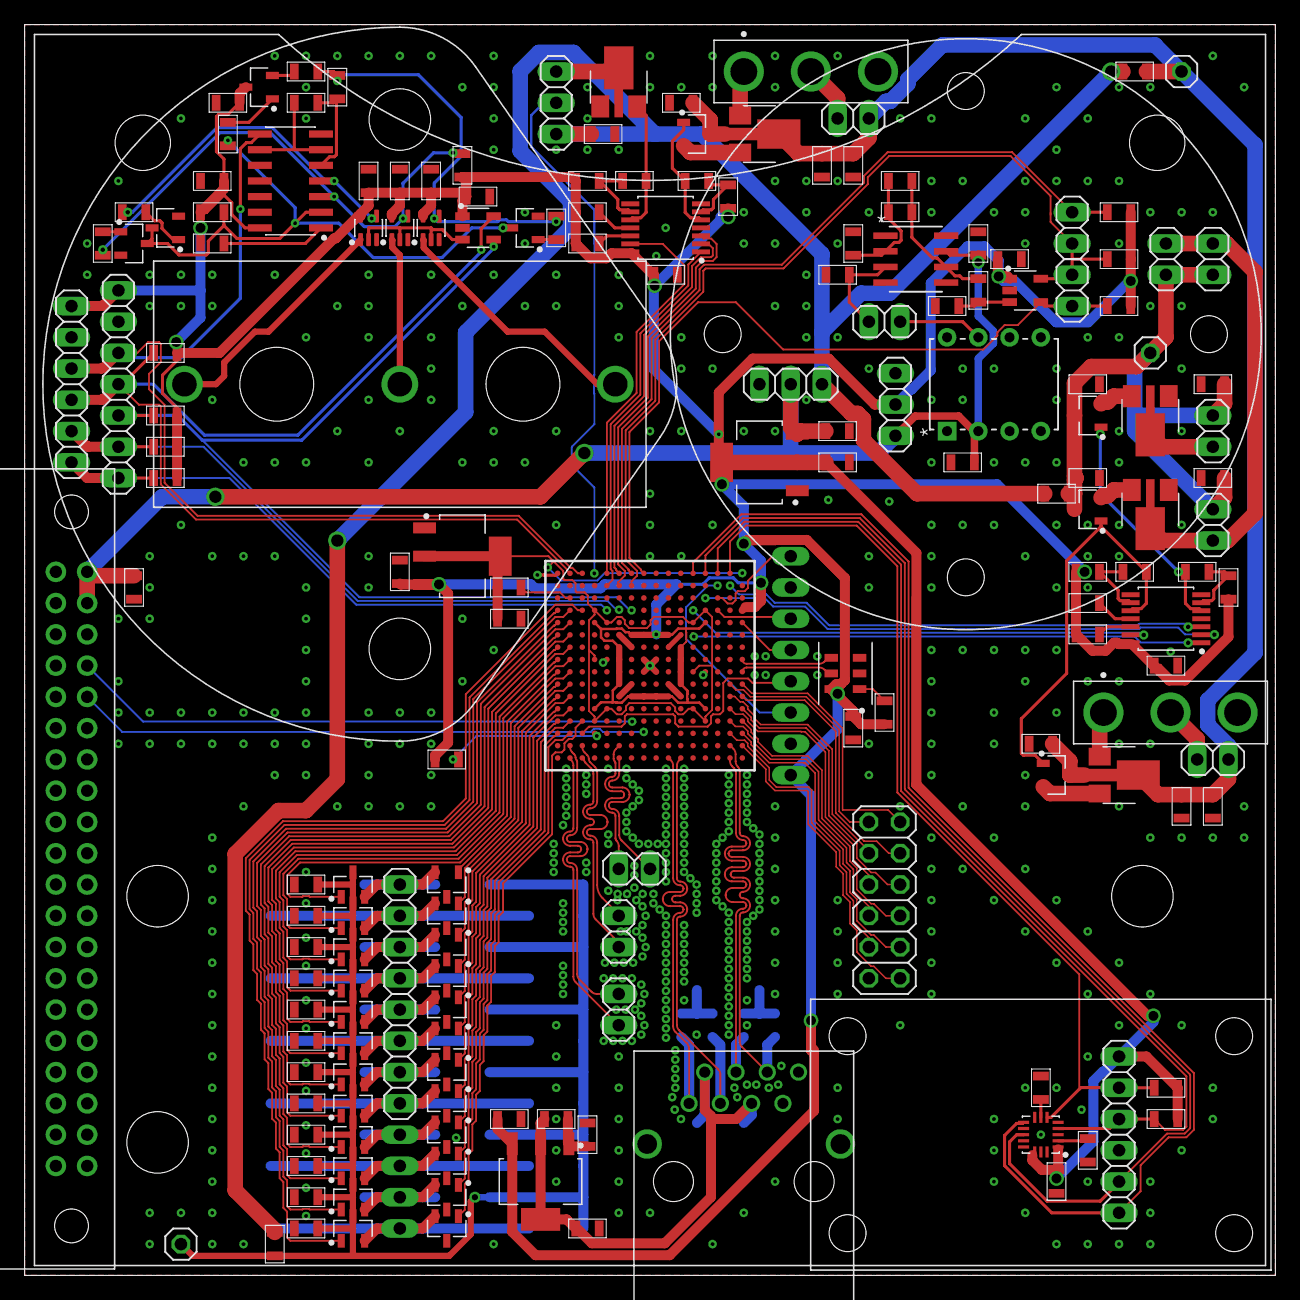
[picture p78: board Rev 1.brd from above]

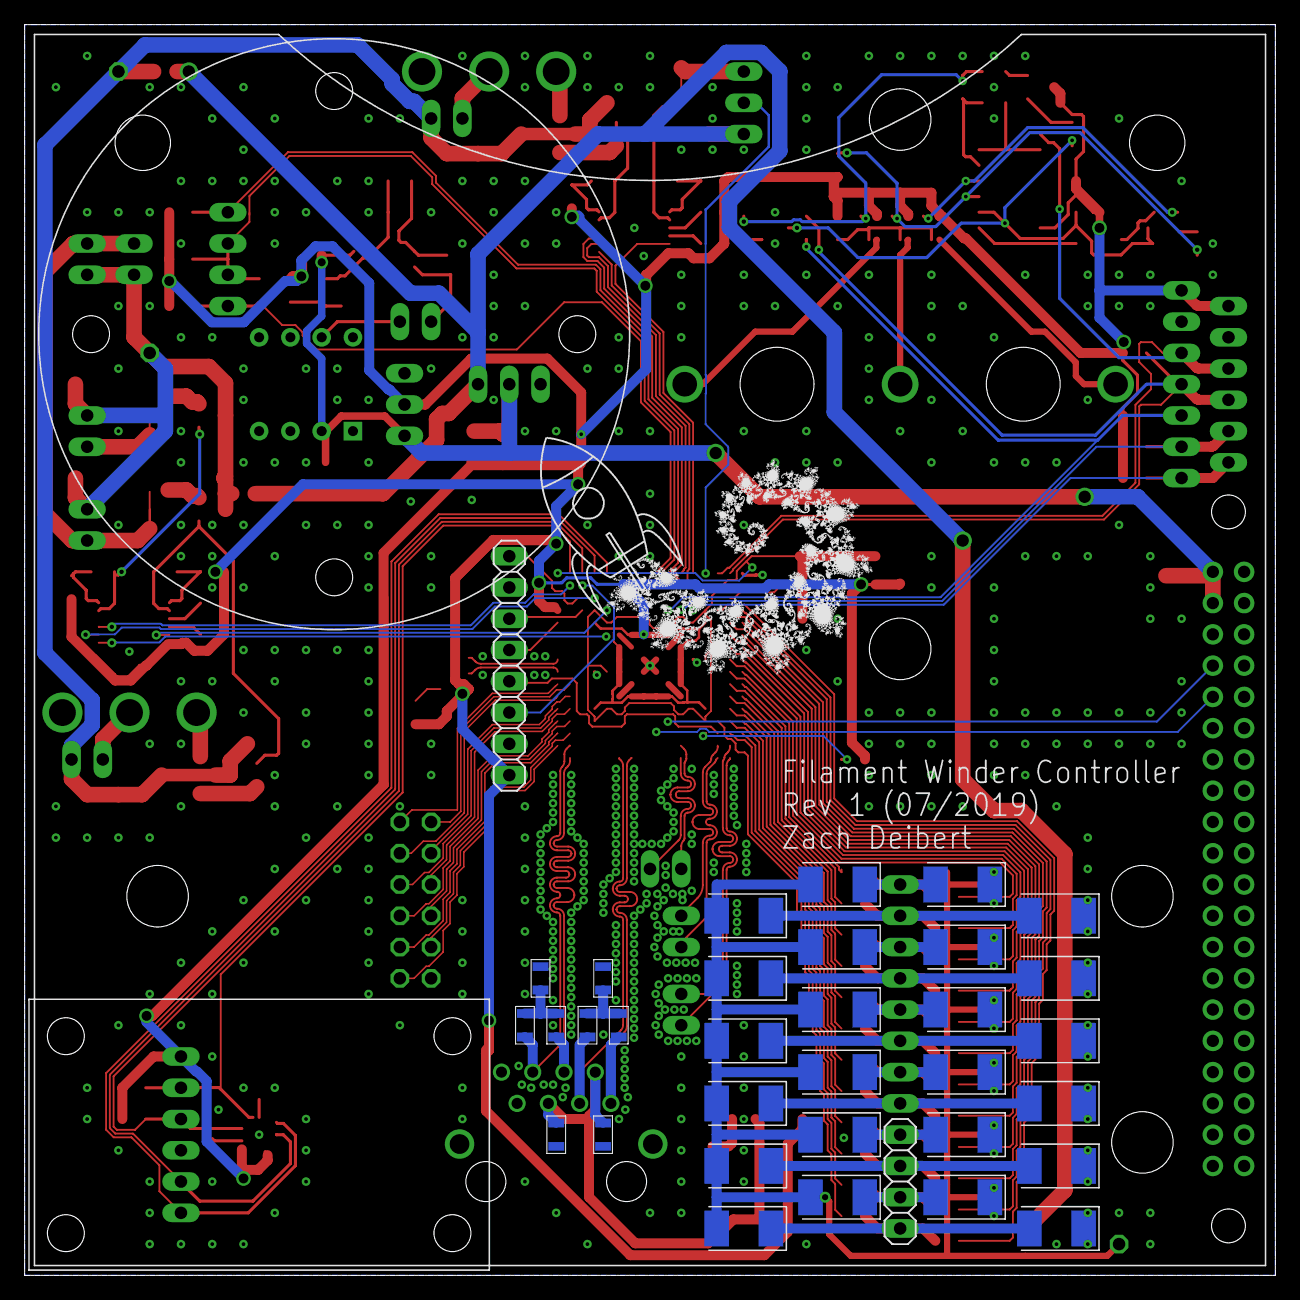
[picture p79: board Rev 1.brd from below]

Board: 2 copper layers, 101.6 x 101.6 mm, 212 parts (34 on the bottom side), 148 nets.
