panatmospheric-voyage/filament-winder/(commit log)

2019-07-26 Created initial version of parts
    [Accelerometer PCB.SLDPRT, Aluminum Extrusion.SLDPRT, Aluminum Extrusion.xlsx, Axle Support.SLDPRT, Axle.SLDPRT, Base.SLDASM, Basin Plate.SLDPRT, Basin.SLDPRT]
2019-07-26 2/12 symbols and footprints created
2019-07-27 Did a bunch of schematic work
    [Rev 1.sch]
2019-07-27 Did most of the rest of the schematic
    [Rev 1.sch]
2019-07-27 Finished more of the schematic
    [Rev 1.sch]
2019-07-27 Added power circuitry
    [Power Budget.xlsx, Rev 1.sch]
2019-07-28 Cleaned up schematic some
    [Rev 1.sch]
2019-07-28 Started board layout
    [Rev 1.brd, Rev 1.sch]
2019-07-28 Layed out board
    [Rev 1.brd, Rev 1.sch]
2019-07-28 Added GPIO pins
    [Rev 1.brd, Rev 1.sch]
2019-07-28 Updated silk screen
    [Rev 1.brd, Rev 1.sch]
2020-02-10 Redesigned pulley injection mold
    [Filament Pulley Injection Mold.SLDPRT, Filament Pulley.SLDPRT]
